yeswantsakthi-hub/NadiSense/docs/NadiSense_VK26-AU-FD-0015_Stage2.pdf

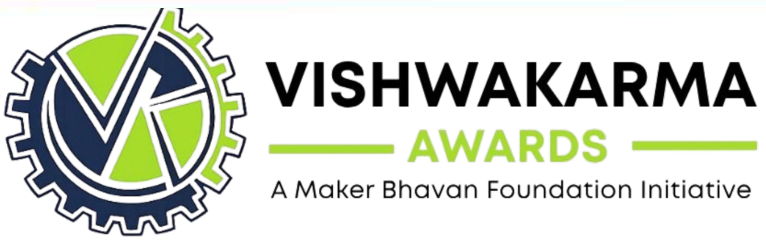
[picture p2: figure]
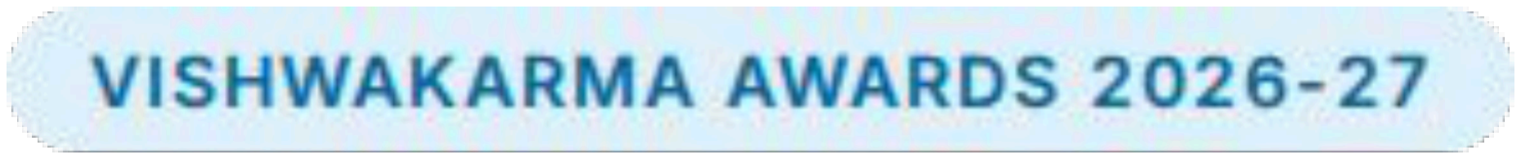
[picture p3: figure]

# Vishwakarma Application ID

# VK26-AU-FD-0015

## NadiSense: a ring that checks your pulse, oxygen and temperature while you sleep

Frontier Diagnostics: The Next Vital Signs, Team Ring of Care, Rajalakshmi Engineering College

Sources: NFHS-5 analyses (medRxiv 2024); ResMed economic model, ISPOR Europe 2025; MoHFW Health Dynamics of India 2022-23.

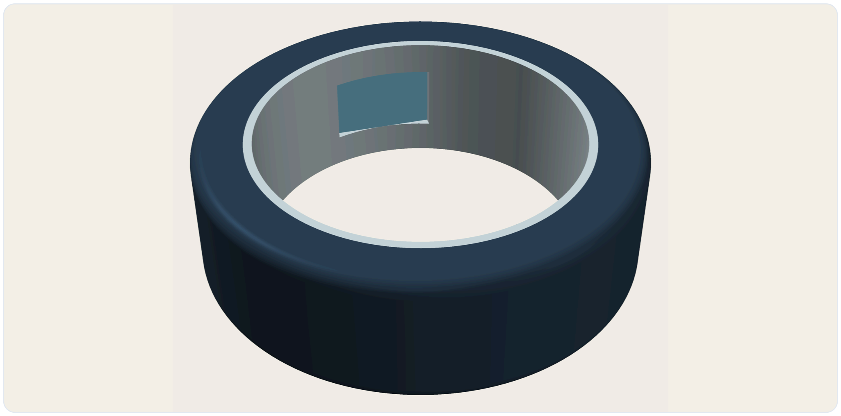
[picture p4: figure]

Figure: NadiSense ring v2, CAD render (AI Generated)

### Target Beneficiary & Problem Statement

Target User: adults aged 30–60 in semi-urban and rural India, starting with Chennai’s peri-urban PHC/CHC areas.
Pain Point: hypertension, irregular heart rhythm and sleep apnea are only caught by one-off tests: a BP cuff, an ECG or an overnight sleep study.
Gap: nobody measures at night, and rural clinics often have no specialist to run these tests.
Existing Solutions: current smart rings are fitness gadgets for city users, with no link to a PHC referral.
Problem Context & Project Overview | VK26-AU-FD-0015
Project: NadiSense | Track: Frontier Diagnostics | Core idea: a pulse, SpO₂ and temperature ring worn overnight.

Sources: NFHS-5 hypertension cascade (medRxiv); ResMed economic model, ISPOR Europe 2025; MoHFW Health Dynamics of India 2022-23.

### Silent signs

Snoring, fatigue, palpitations
dismissed as normal

### No routine check

BP checked rarely; nobody
measures at night

### Facility-bound

Cuff at PHC, ECG/Holter,
overnight sleep lab

### Late detection

First sign is often a stroke or heart event

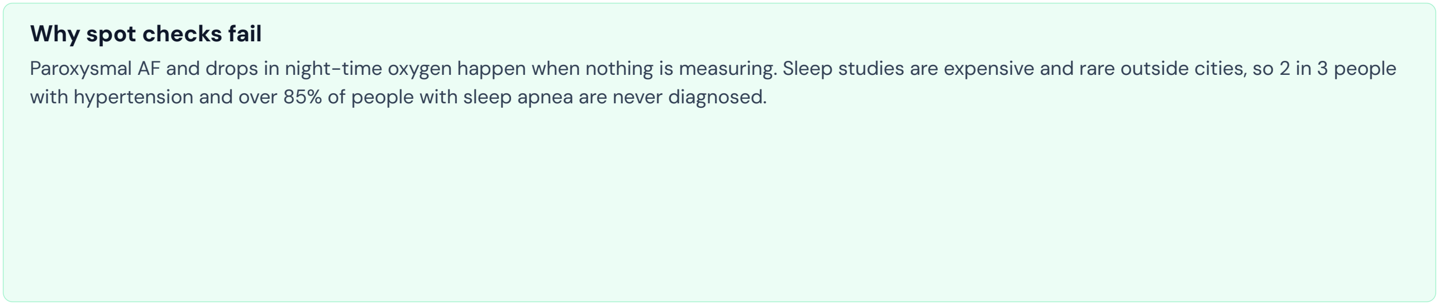
[picture p5: figure]
Why spot checks fail

Paroxysmal AF and drops in night-time oxygen happen when nothing is measuring. Sleep studies are expensive and rare outside cities, so 2 in 3 people with hypertension and over 85% of people with sleep apnea are never diagnosed.

User Journey: Before State | VK26-AU-FD-0015

Bottleneck: every step depends on the patient going to a clinic, so problems are found late.

~8 h

DATA PER NIGHT

0

CLINIC VISITS TO SCREEN

< 60 s

SYNC TO RISK REPORT

≈ ₹100

HARDWARE PER SCREENING

### Wear the ring

No cuff, no clinic, no straps

### Passive capture

Pulse wave, HRV, SpO₂, skin temp

### Risk flags

Stiffness, AF-type rhythm, apnea

### Early referral

Report for PHC doctor or
teleconsult

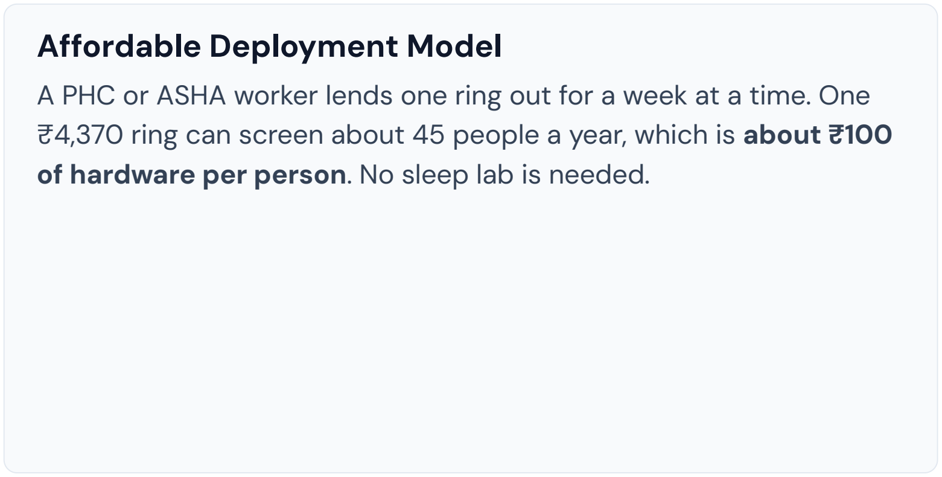
[picture p6: figure]
Affordable Deployment Model

A PHC or ASHA worker lends one ring out for a week at a time. One ₹4,370 ring can screen about 45 people a year, which is about ₹100 of hardware per person. No sleep lab is needed.

User Journey: After State | VK26-AU-FD-0015

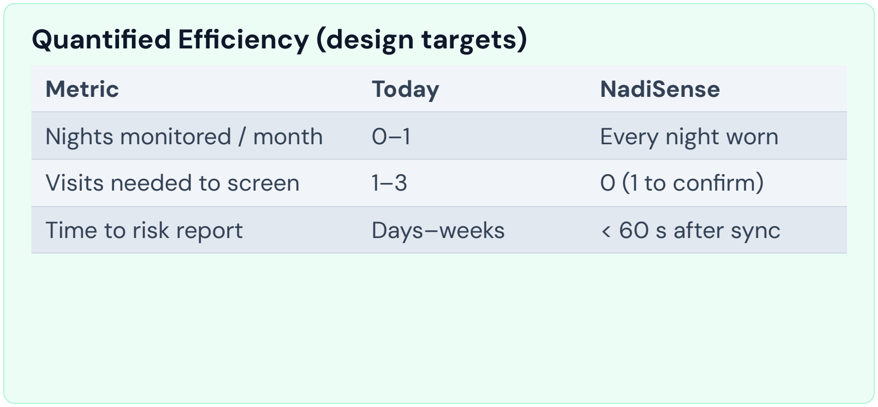
[picture p7: figure]
Quantified Efficiency (design targets); Metric; Today; NadiSense; Nights monitored / month; Every night worn; Visits needed to screen; 0 (1 to confirm); Time to risk report; Days–weeks; < 60 s after sync

Scope: NadiSense flags risk and refers to a doctor; it does not diagnose. We will test these targets in Stage 3.

### Sensing

### Control & Power

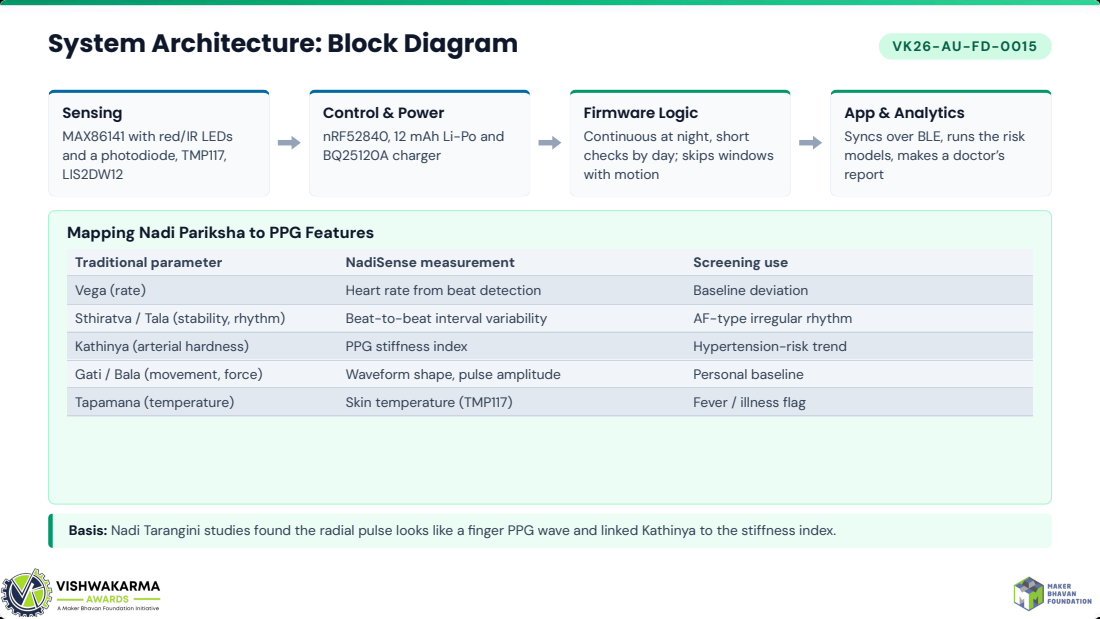
[picture p8: page 5]
System Architecture: Block Diagram

Firmware Logic
Continuous at night, short
checks by day; skips windows
with motion

App & Analytics
Syncs over BLE, runs the risk
models, makes a doctor’s
report

MAX86141 with red/IR LEDs
and a photodiode, TMP117,
LIS2DW12

nRF52840, 12 mAh Li-Po and
BQ25120A charger

Mapping Nadi Pariksha to PPG Features

Traditional parameter | NadiSense measurement | Screening use
Vega (rate) | Heart rate from beat detection | Baseline deviation
Sthiratva / Tala (stability, rhythm) | Beat-to-beat interval variability | AF-type irregular rhythm
Kathinya (arterial hardness) | PPG stiffness index | Hypertension-risk trend
Gati / Bala (movement, force) | Waveform shape, pulse amplitude | Personal baseline
Tapamana (temperature) | Skin temperature (TMP117) | Fever / illness flag

Basis: Nadi Tarangini studies found the radial pulse looks like a finger PPG wave and linked Kathinya to the stiffness index.

≈ 3 g

# 40 µA

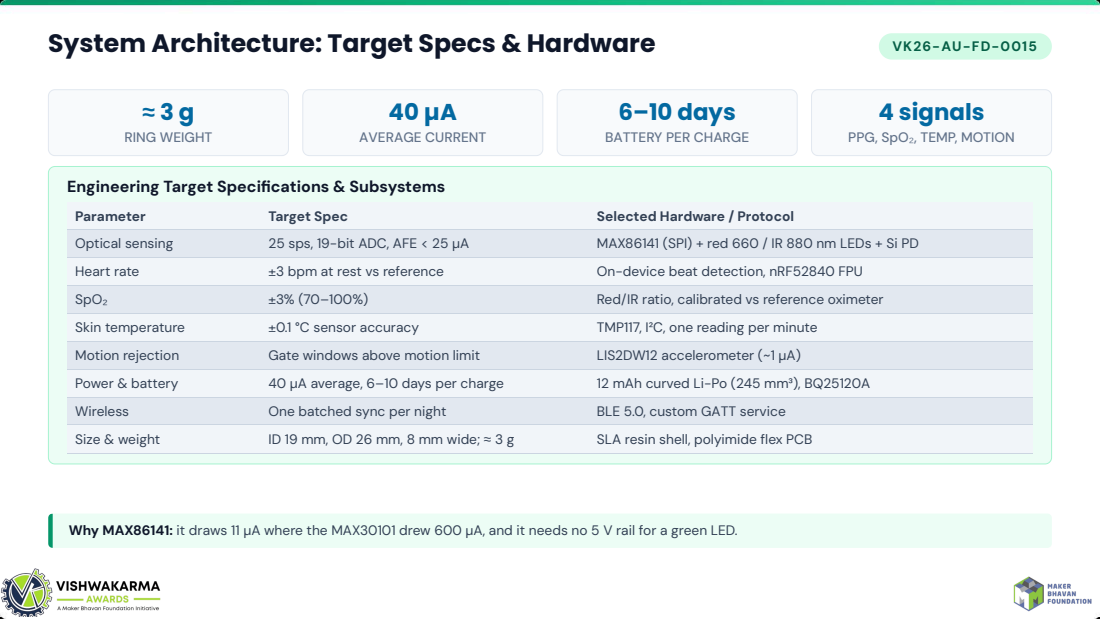
[picture p9: page 6]
RING WEIGHT; AVERAGE CURRENT; 6–10 days; 4 signals; System Architecture: Target Specs & Hardware

BATTERY PER CHARGE

PPG, SpO₂, TEMP, MOTION

Engineering Target Specifications & Subsystems

Parameter | Target Spec | Selected Hardware / Protocol
Optical sensing | 25 sps, 19-bit ADC, AFE < 25 µA | MAX86141 (SPI) + red 660 / IR 880 nm LEDs + Si PD
Heart rate | ±3 bpm at rest vs reference | On-device beat detection, nRF52840 FPU
SpO₂ | ±3% (70–100%) | Red/IR ratio, calibrated vs reference oximeter
Skin temperature | ±0.1 °C sensor accuracy | TMP117, I²C, one reading per minute
Motion rejection | Gate windows above motion limit | LIS2DW12 accelerometer (~1 µA)
Power & battery | 40 µA average, 6–10 days per charge | 12 mAh curved Li-Po (245 mm³), BQ25120A
Wireless | One batched sync per night | BLE 5.0, custom GATT service
Size & weight | ID 19 mm, OD 26 mm, 8 mm wide; ≈ 3 g | SLA resin shell, polyimide flex PCB

Why MAX86141: it draws 11 µA where the MAX30101 drew 600 µA, and it needs no 5 V rail for a green LED.

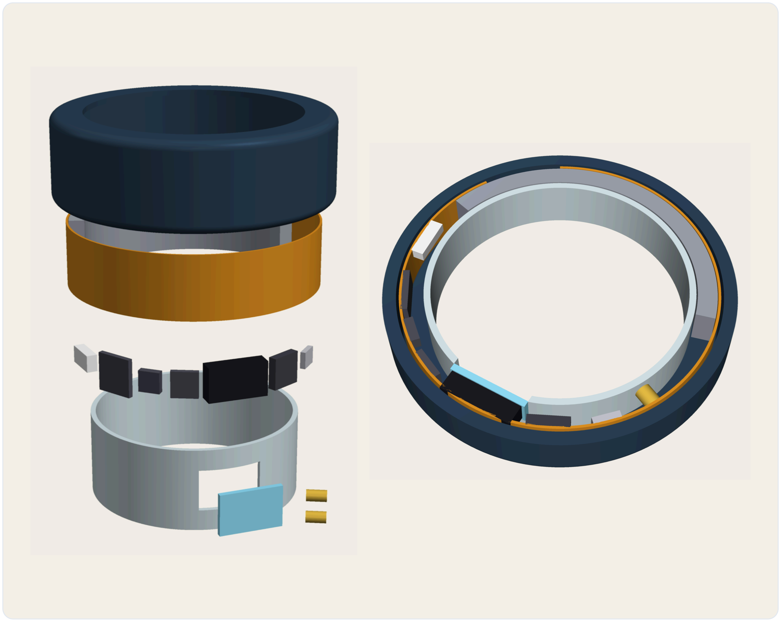
[picture p10: figure]

Figure: exploded assembly and half-section, ring v2 (AI Generated)

### Mechanical Design & Material Selection

Envelope: ID 19 mm, OD 26 mm, 8 mm wide; wall = 0.5 liner + 2.0 cavity + 1.0 shell.
Shell: biocompatible SLA resin U-channel, 0.8 mm outer and 0.3 mm inner fillets.
Liner: clear resin with a 6 × 4 mm optical window sealed in clear epoxy.
Layout: 245 mm³ curved Li-Po on the back of the finger; optics on the palm side; flex PCB wraps 330°.
Mass: ≈ 3 g estimated from CAD volumes.
CAD Design & Mechanical Specs | VK26-AU-FD-0015

Design Iteration: we first planned a 20–40 mAh cell, but the CAD cavity holds only 245 mm³, so we resized it to 12 mAh.

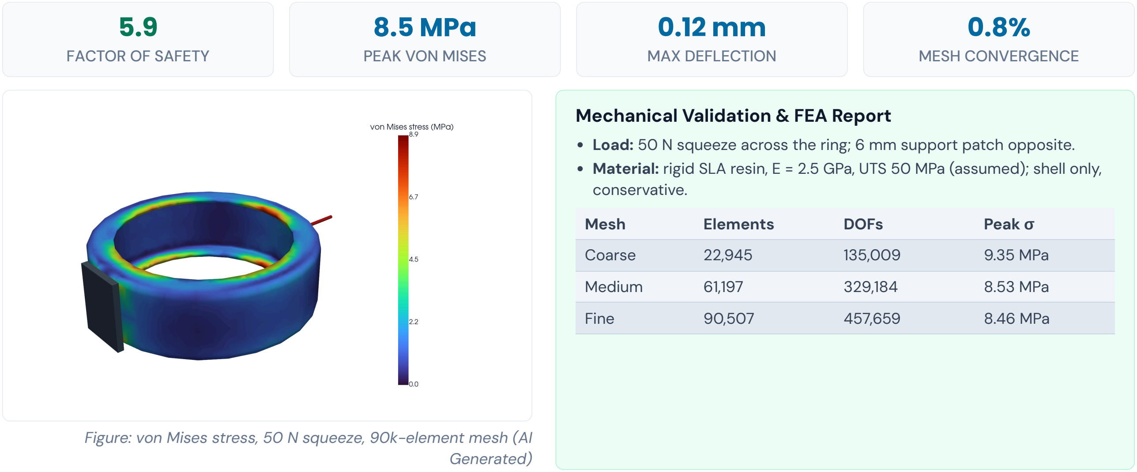
[picture p11: figure]
FACTOR OF SAFETY; 8.5 MPa; PEAK VON MISES; MAX DEFLECTION; MESH CONVERGENCE; Generated); Mechanical Validation & FEA Report; conservative.; Mesh; Elements; DOFs; Peak σ; Coarse; 9.35 MPa; Medium; 8.53 MPa; Fine; 8.46 MPa

Figure: von Mises stress, 50 N squeeze, 90k-element mesh (AI

Load: 50 N squeeze across the ring; 6 mm support patch opposite. Material: rigid SLA resin, E = 2.5 GPa, UTS 50 MPa (assumed); shell only,

CAD Design: FEA Stress Analysis | VK26-AU-FD-0015

Design Iteration: we added 0.3 mm fillets at the inner channel corners before the analysis to remove sharp stress points.

Electronics Schematics & Power Budget | VK26-AU-FD-0015

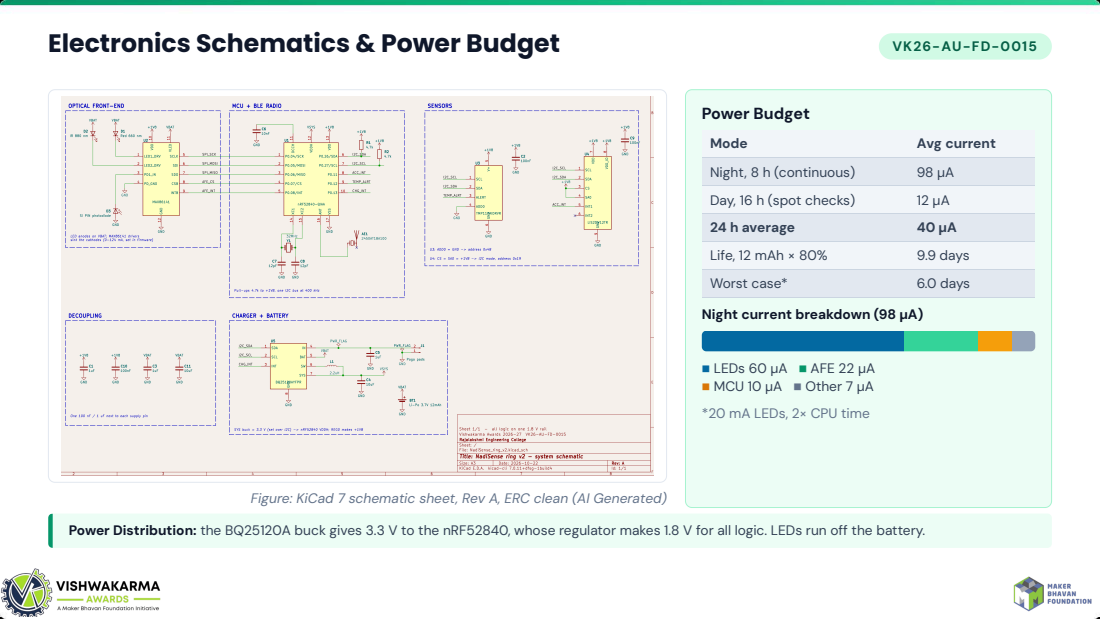
[picture p12: page 9]
Power Budget

Mode | Avg current
Night, 8 h (continuous) | 98 µA
Day, 16 h (spot checks) | 12 µA
24 h average | 40 µA
Life, 12 mAh × 80% | 9.9 days
Worst case* | 6.0 days

Night current breakdown (98 µA)

■ LEDs 60 µA ■ AFE 22 µA
■ MCU 10 µA ■ Other 7 µA
*20 mA LEDs, 2× CPU time

Figure: KiCad 7 schematic sheet, Rev A, ERC clean (AI Generated)

Power Distribution: the BQ25120A buck gives 3.3 V to the nRF52840, whose regulator makes 1.8 V for all logic. LEDs run off the battery.

### Itemized Bill of Materials (one ring)

Ref | Component | Part / Specification | Sourcing / Lead Time | Est. (INR)
U1 | BLE SoC | nRF52840, WLCSP | Distributor (5–7 days) | ₹420
U2 | Optical AFE | MAX86141, WLP | Distributor (5–7 days) | ₹520
U3 | Temperature | TMP117, ±0.1 °C | Distributor (5–7 days) | ₹260
U4 | Accelerometer | LIS2DW12 | Distributor (5–7 days) | ₹140
U5 | Charger | BQ25120A | Distributor (5–7 days) | ₹180
D1–D3 | Optics | Red/IR SMD LEDs, Si photodiode | Distributor (5–7 days) | ₹220
Y1, AE1, L1 | RF + passives | 32 MHz crystal, chip antenna, 2.2 µH, R/C | Distributor (5–7 days) | ₹230
PCB | Flex PCB | 2-layer polyimide, 0.2 mm | Imported (10–14 days) | ₹700
BT1 | Battery | 12 mAh curved Li-Po (custom) | Imported (3–4 weeks) | ₹1,200
MECH | Shell, liner, potting | SLA resin, epoxy, silicone, pogo pads | Local (4 days) | ₹500
| Total per unit | | | ₹4,370
Electronics BOM & Procurement | VK26-AU-FD-0015

Procurement Risk: the custom curved cell has the longest lead time, so it is ordered first, in Month 1.

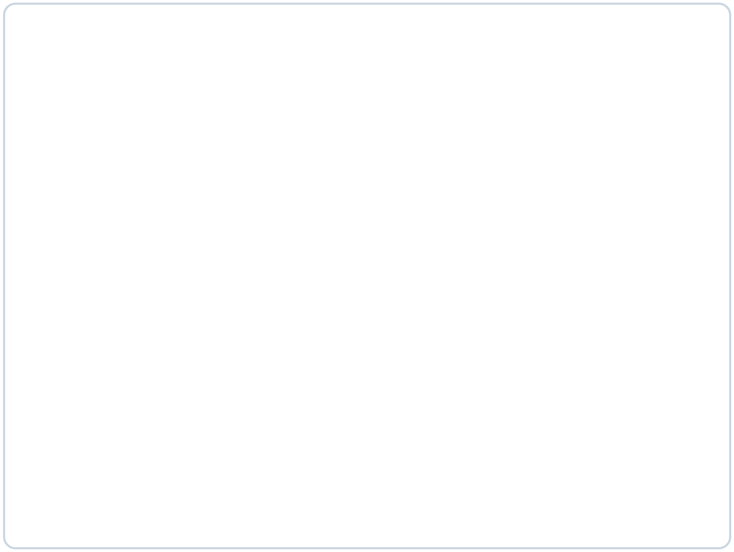
[picture p13: figure]

Figure: Team Ring of Care, REC

### Stage 1 to Stage 2 Design Iterations

Form factor: moved from a handheld reader to a ring so we can record through the night.
Sensing: added SpO₂, skin temperature and motion sensing to the PPG.
Optical AFE: the power budget ruled out the MAX30101 (600 µA), so we moved to the MAX86141 (11 µA).
Battery: cut from 20–40 mAh to 12 mAh to fit the CAD cavity; still 6–10 days per charge.
Shell: 0.3 mm internal fillets added; FEA safety factor 5.9 at 50 N.
Software: companion app live at nadisense-app.vercel.app in 8 Indian languages, running on simulated sensor data until the ring is built.
Repository: github.com/yeswantsakthi-hub/NadiSense, with STEP files, KiCad project, FEA scripts, power budget and app code.
Your Maker Journey | VK26-AU-FD-0015

Institutional Sign-Off: design reviewed by Faculty Guide Dr. L. Bhagyalakshmi, Professor, Dept. of ECE (WSN, IoT, ML & AI), Rajalakshmi Engineering

Your Maker Journey: Design Tools | VK26-AU-FD-0015

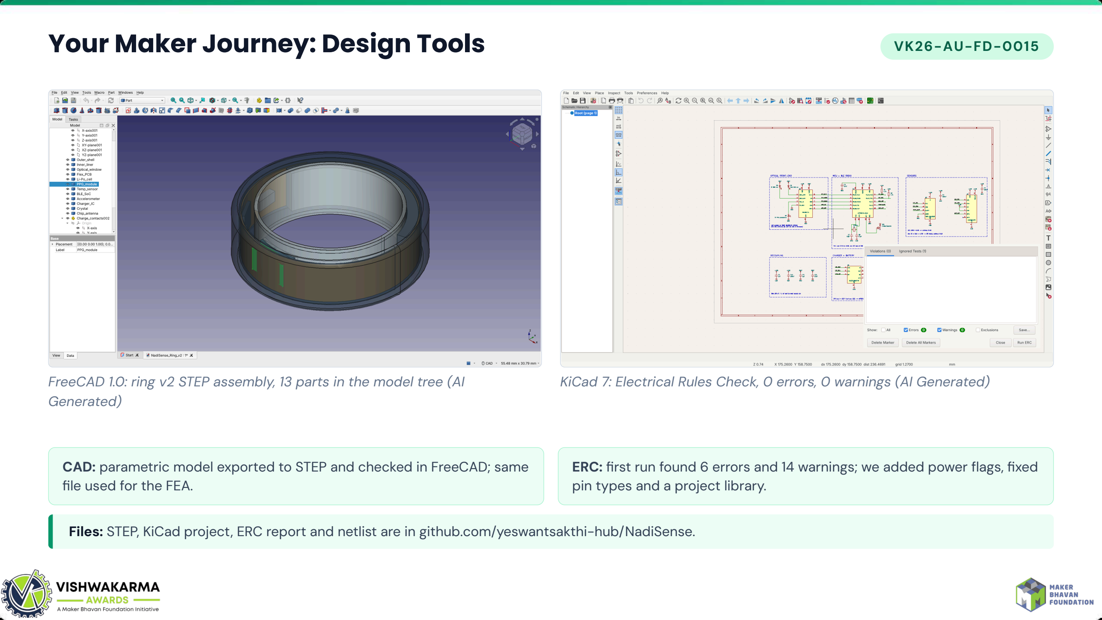
[picture p14: page 12]

FreeCAD 1.0: ring v2 STEP assembly, 13 parts in the model tree (AI Generated)

KiCad 7: Electrical Rules Check, 0 errors, 0 warnings (AI Generated)

CAD: parametric model exported to STEP and checked in FreeCAD; same file used for the FEA.

ERC: first run found 6 errors and 14 warnings; we added power flags, fixed pin types and a project library.

Files: STEP, KiCad project, ERC report and netlist are in github.com/yeswantsakthi-hub/NadiSense.

### Design FMEA (Severity × Occurrence × Detection, each 1–10)

Failure Mode | Potential Hazard | Embedded Fail-Safe / Mitigation | S | O | D | RPN
Cell overheat | Burn at the finger | Charger thermal limit; cut-off above 43 °C | 9 | 2 | 3 | 54
LED skin heating | Warmth, discomfort | LED current cap; duty-cycled sampling | 5 | 2 | 4 | 40
Motion artifact | False alert | IMU gating; alert only on repeat episodes | 4 | 6 | 4 | 96
Missed event | False reassurance | Never shows “all clear”; clinical check | 8 | 4 | 6 | 192
Data exposure | Privacy breach | On-phone processing; encrypted BLE and storage | 6 | 2 | 5 | 60

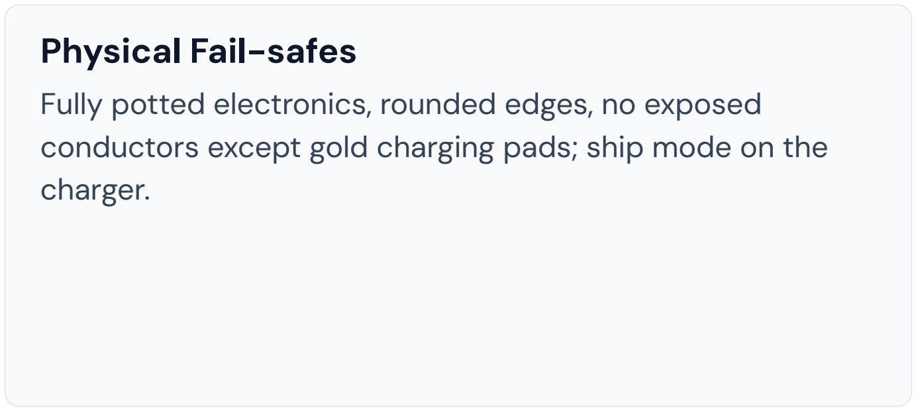
[picture p15: figure]
Physical Fail-safes; charger.

Fully potted electronics, rounded edges, no exposed conductors except gold charging pads; ship mode on the

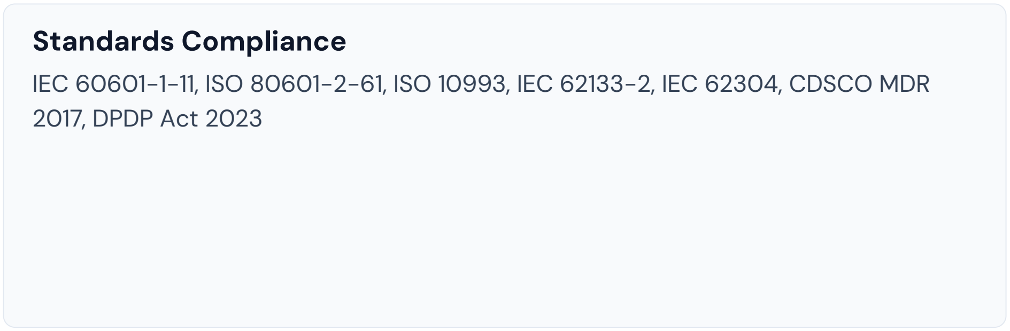
[picture p16: figure]
Standards Compliance; 2017, DPDP Act 2023

IEC 60601-1-11, ISO 80601-2-61, ISO 10993, IEC 62133-2, IEC 62304, CDSCO MDR

Safety & Hazard Mitigation | VK26-AU-FD-0015

Highest RPN: missed event (192). The app never says “all clear”, and every flag ends in a referral.

Nov 2026 | Dec 2026 | Jan 2027 | Feb 2027
Roadmap: 4-Month Fabrication Plan | VK26-AU-FD-0015

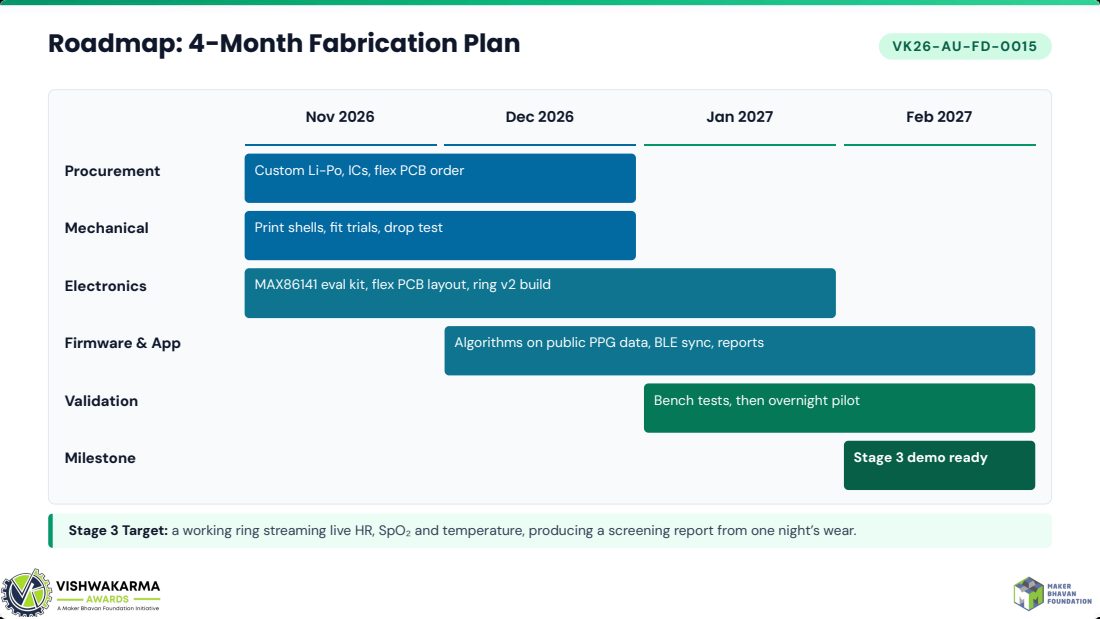
[picture p17: page 14]
Procurement; Custom Li-Po, ICs, flex PCB order; Mechanical; Print shells, fit trials, drop test; Electronics; MAX86141 eval kit, flex PCB layout, ring v2 build; Firmware & App; Algorithms on public PPG data, BLE sync, reports; Validation; Bench tests, then overnight pilot; Milestone; Stage 3 demo ready

Stage 3 Target: a working ring streaming live HR, SpO₂ and temperature, producing a screening report from one night’s wear.

Technical Challenges & Risks | VK26-AU-FD-0015

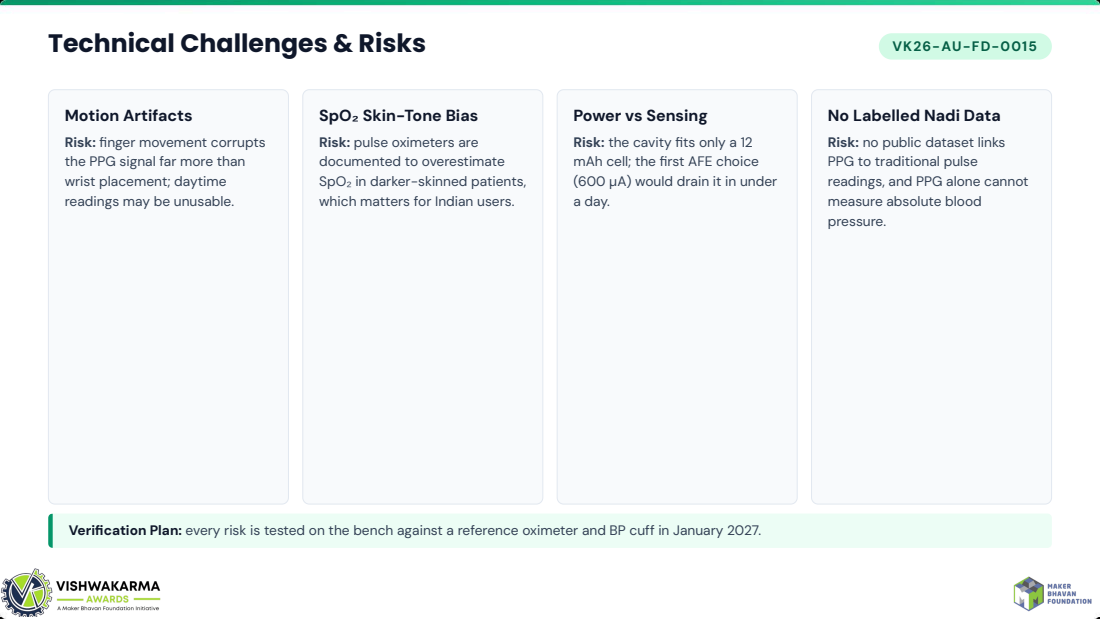
[picture p18: page 15]

Motion Artifacts
Risk: finger movement corrupts
the PPG signal far more than
wrist placement; daytime
readings may be unusable.

SpO₂ Skin-Tone Bias
Risk: pulse oximeters are
documented to overestimate
SpO₂ in darker-skinned patients,
which matters for Indian users.

Power vs Sensing
Risk: the cavity fits only a 12
mAh cell; the first AFE choice
(600 µA) would drain it in under
a day.

No Labelled Nadi Data
Risk: no public dataset links
PPG to traditional pulse
readings, and PPG alone cannot
measure absolute blood
pressure.

Verification Plan: every risk is tested on the bench against a reference oximeter and BP cuff in January 2027.

Potential Solutions & Risk Mitigation | VK26-AU-FD-0015

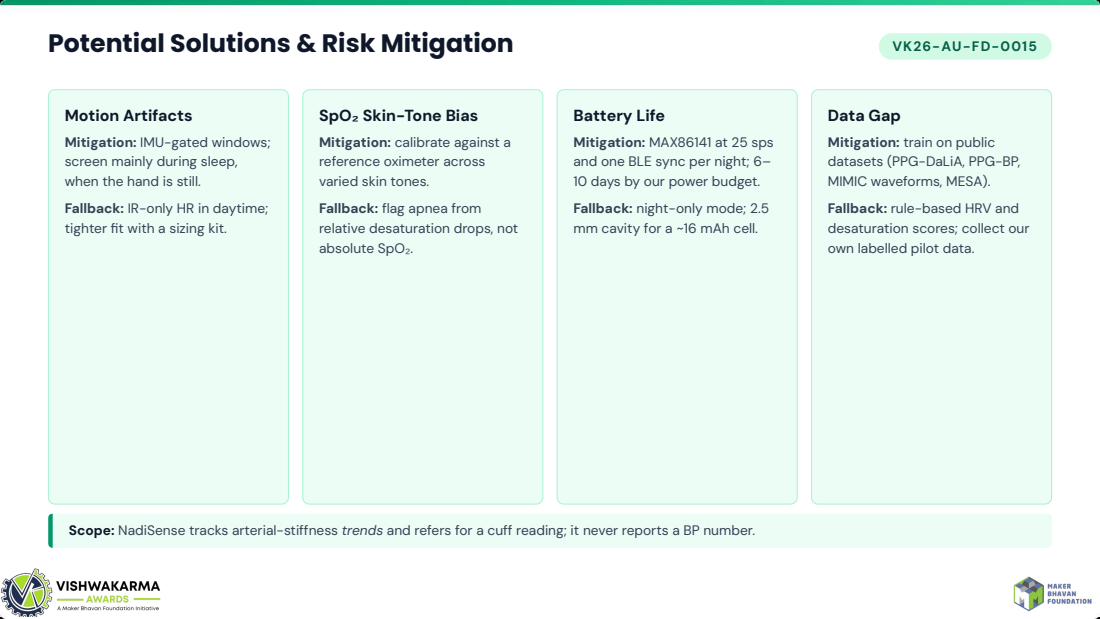
[picture p19: page 16]

Motion Artifacts
Mitigation: IMU-gated windows;
screen mainly during sleep,
when the hand is still.
Fallback: IR-only HR in daytime;
tighter fit with a sizing kit.

SpO₂ Skin-Tone Bias
Mitigation: calibrate against a
reference oximeter across
varied skin tones.
Fallback: flag apnea from
relative desaturation drops, not
absolute SpO₂.

Battery Life
Mitigation: MAX86141 at 25 sps
and one BLE sync per night; 6–
10 days by our power budget.
Fallback: night-only mode; 2.5
mm cavity for a ~16 mAh cell.

Data Gap
Mitigation: train on public
datasets (PPG-DaLiA, PPG-BP,
MIMIC waveforms, MESA).
Fallback: rule-based HRV and
desaturation scores; collect our
own labelled pilot data.

Scope: NadiSense tracks arterial-stiffness trends and refers for a cuff reading; it never reports a BP number.
