yeswantsakthi-hub/NadiSense/docs/screenshots/freecad_ring.png

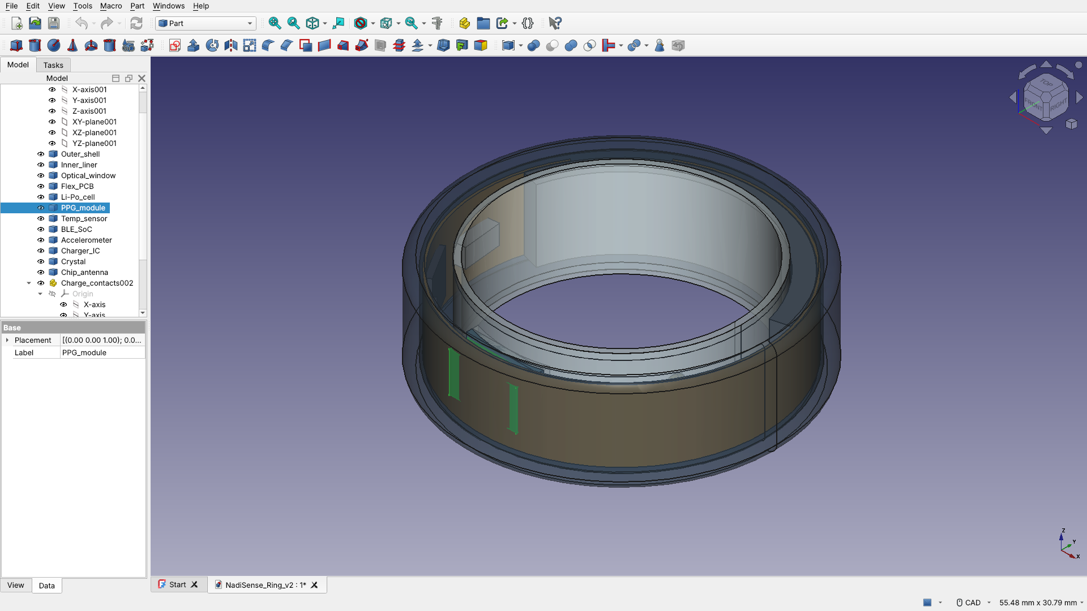
docs/screenshots/freecad_ring.png
