yeswantsakthi-hub/NadiSense/docs/screenshots/kicad_erc.png

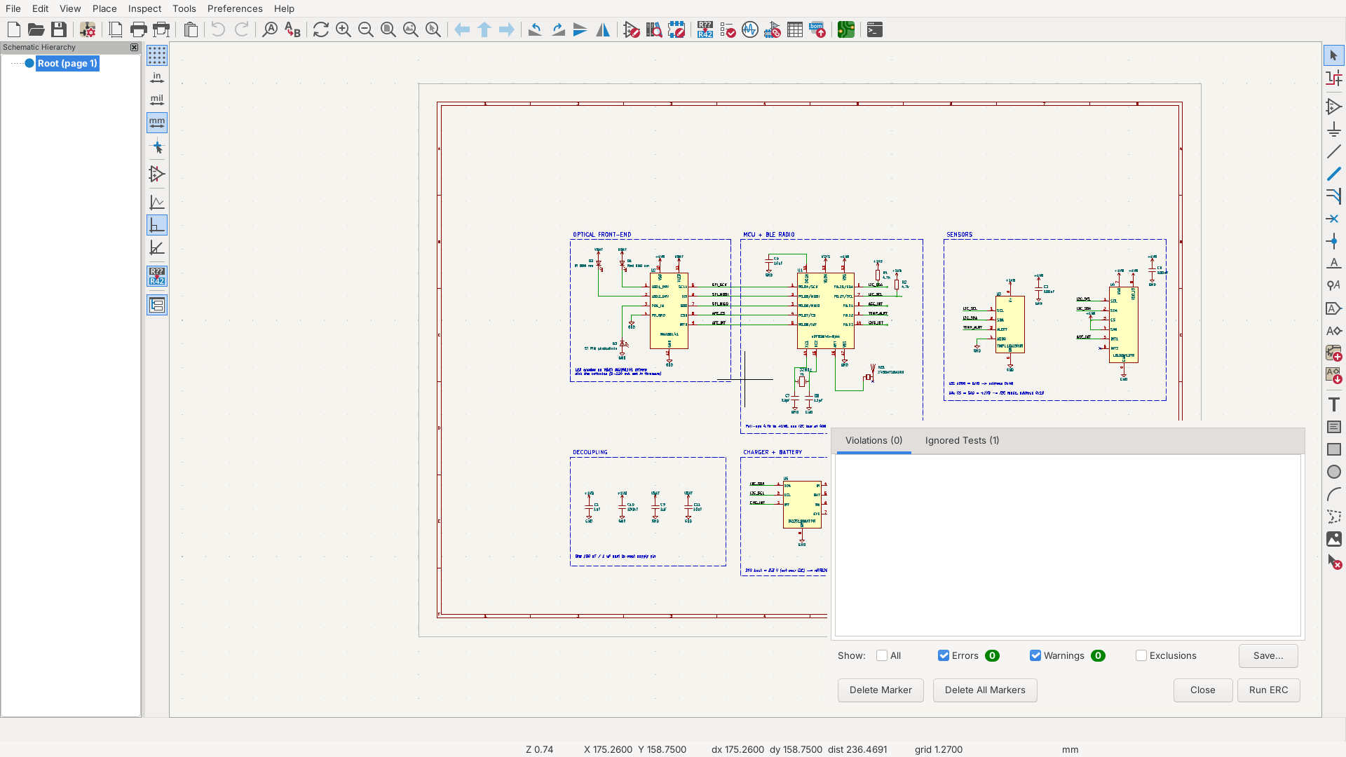
docs/screenshots/kicad_erc.png
