yeswantsakthi-hub/NadiSense/electronics/kicad/NadiSense_ring_v2.png

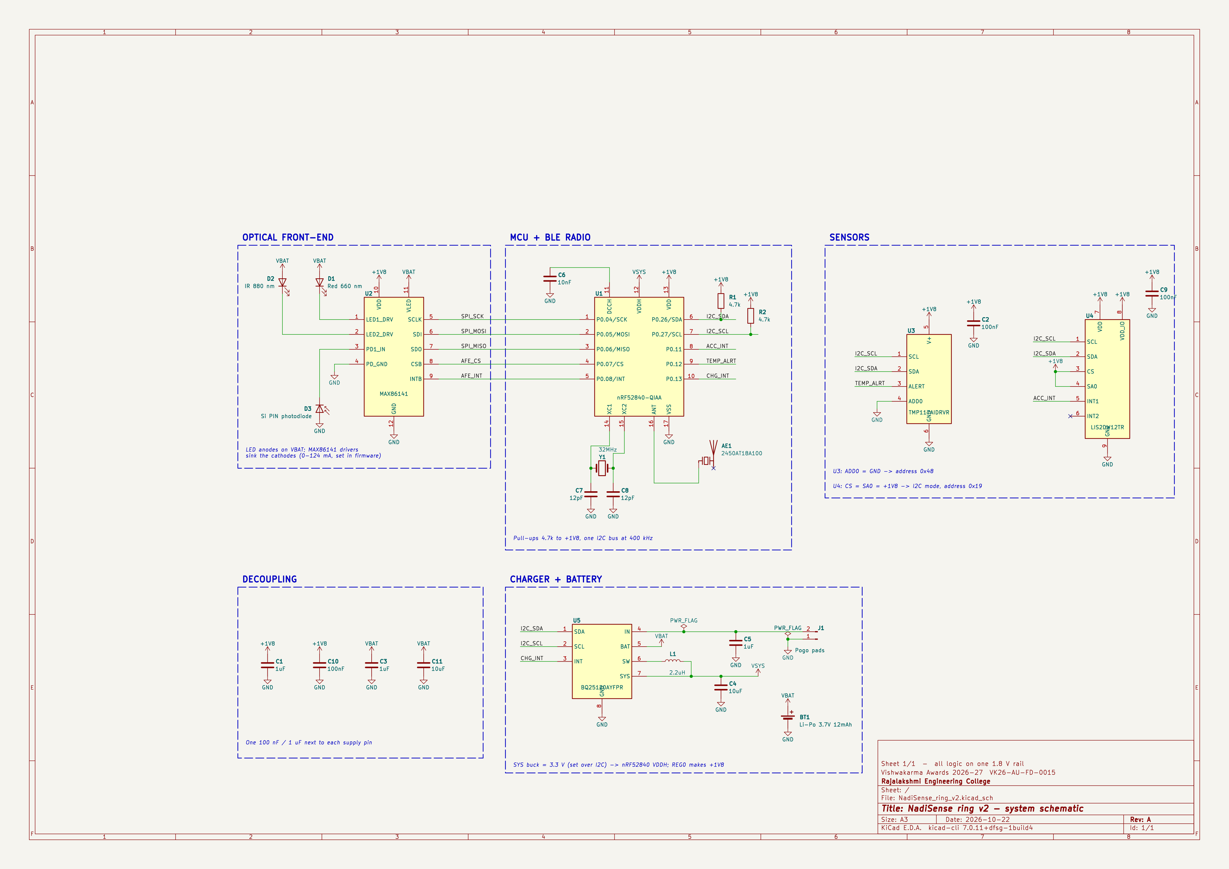
electronics/kicad/NadiSense_ring_v2.png
