yeswantsakthi-hub/NadiSense/electronics/ring_v2_revB/images/pcb3d_flat.png

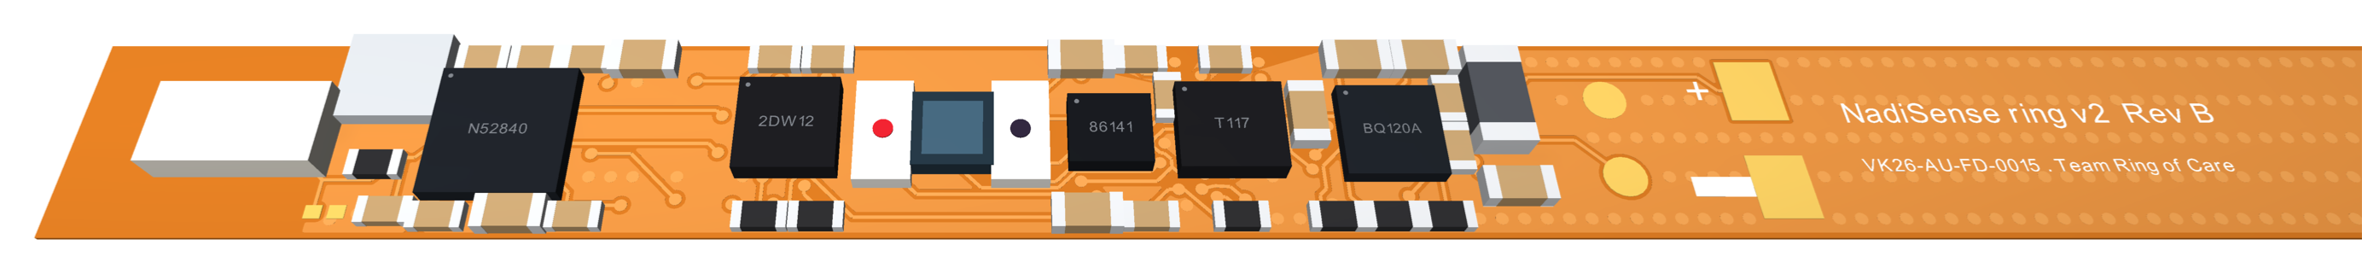
electronics/ring_v2_revB/images/pcb3d_flat.png
