yeswantsakthi-hub/NadiSense/electronics/ring_v2_revB/images/pcb3d_ring.png

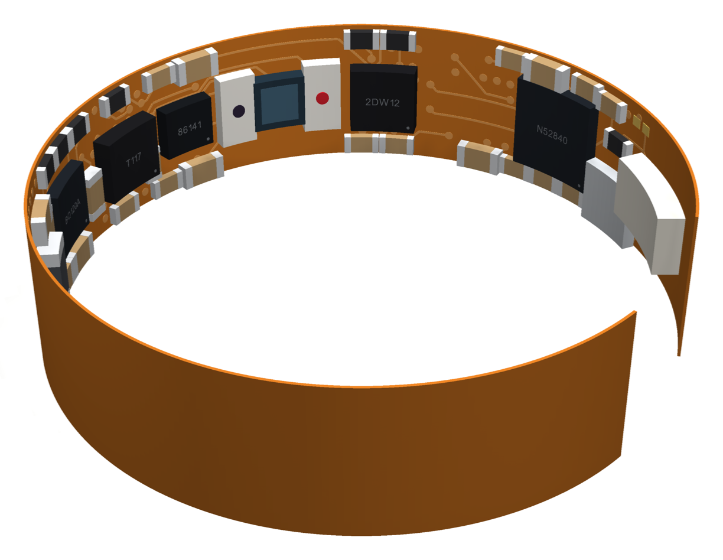
electronics/ring_v2_revB/images/pcb3d_ring.png
