yeswantsakthi-hub/NadiSense/electronics/ring_v2_revB/images/pcb_bottom.png

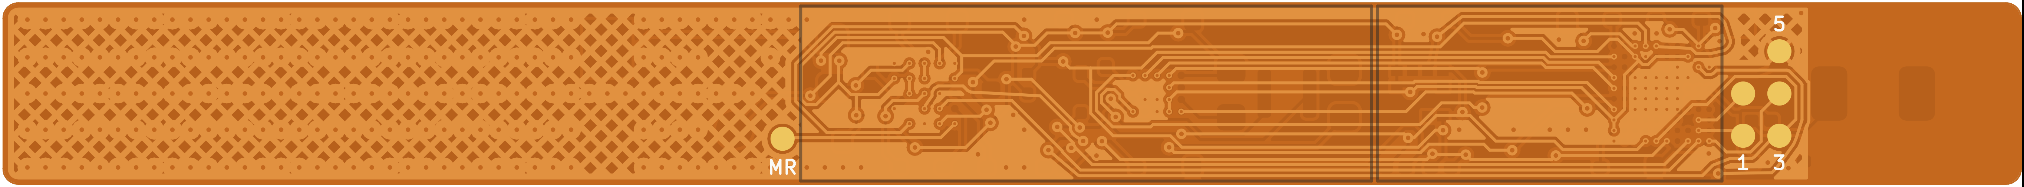
electronics/ring_v2_revB/images/pcb_bottom.png
