yeswantsakthi-hub/NadiSense/electronics/ring_v2_revB/images/pcb_layers.png

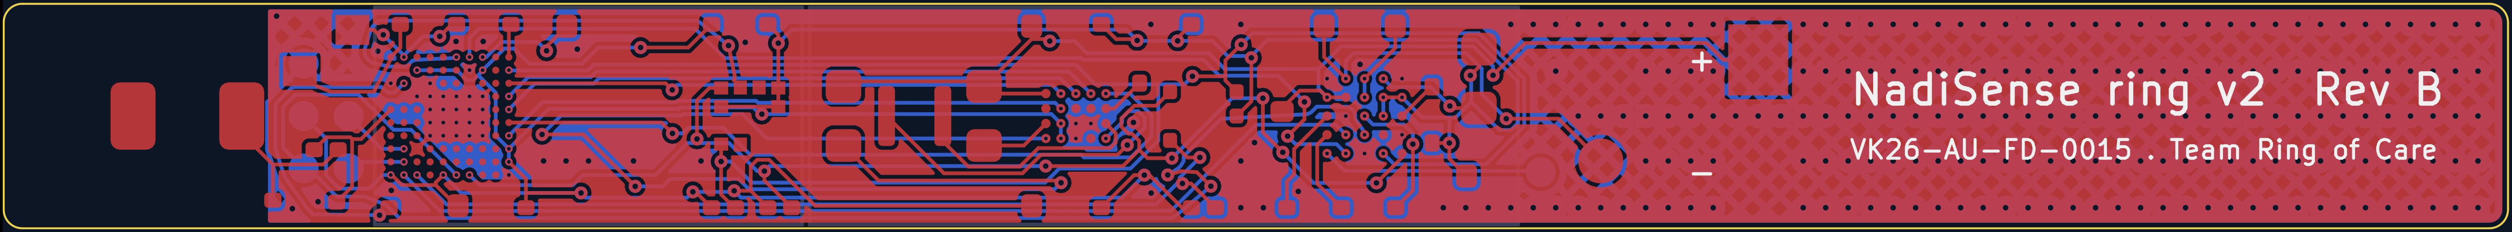
electronics/ring_v2_revB/images/pcb_layers.png
