yeswantsakthi-hub/NadiSense/electronics/ring_v2_revB/images/pcb_routing.png

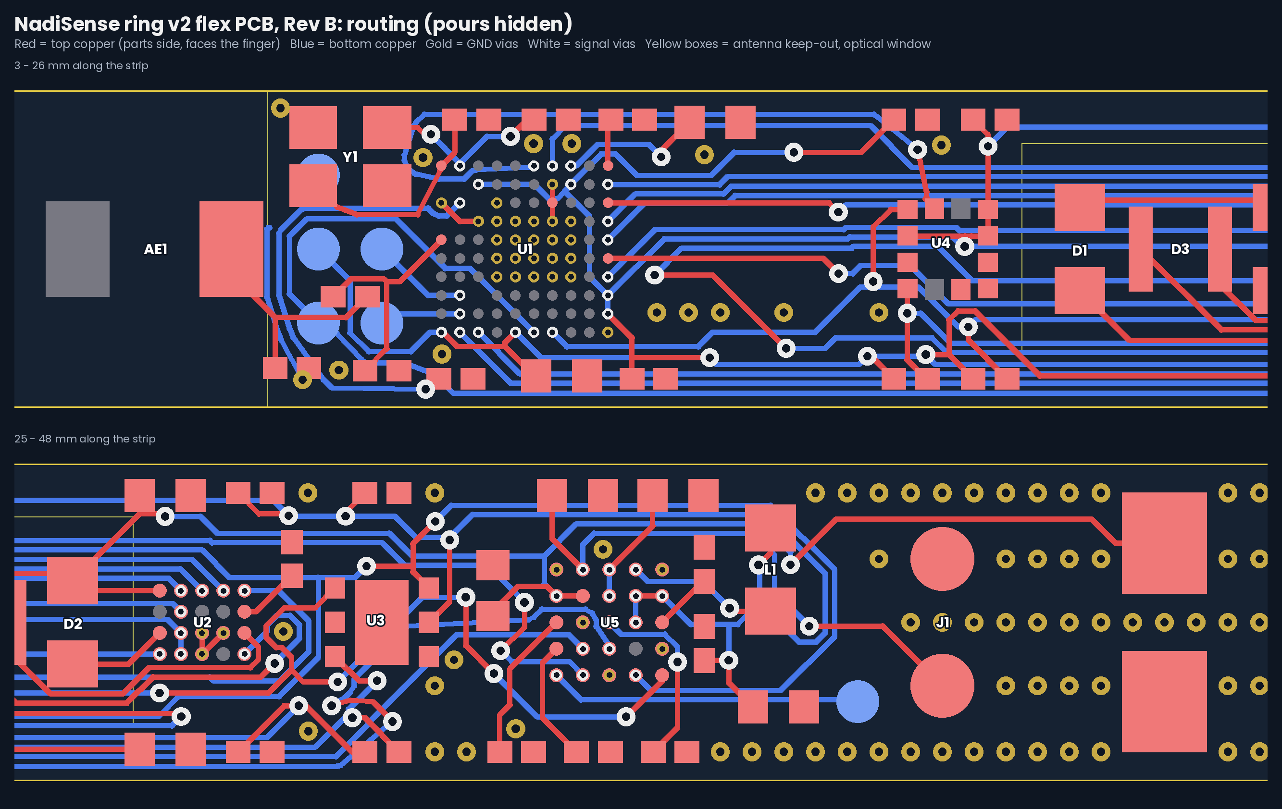
electronics/ring_v2_revB/images/pcb_routing.png
