yeswantsakthi-hub/NadiSense/fea/fea_stress.png

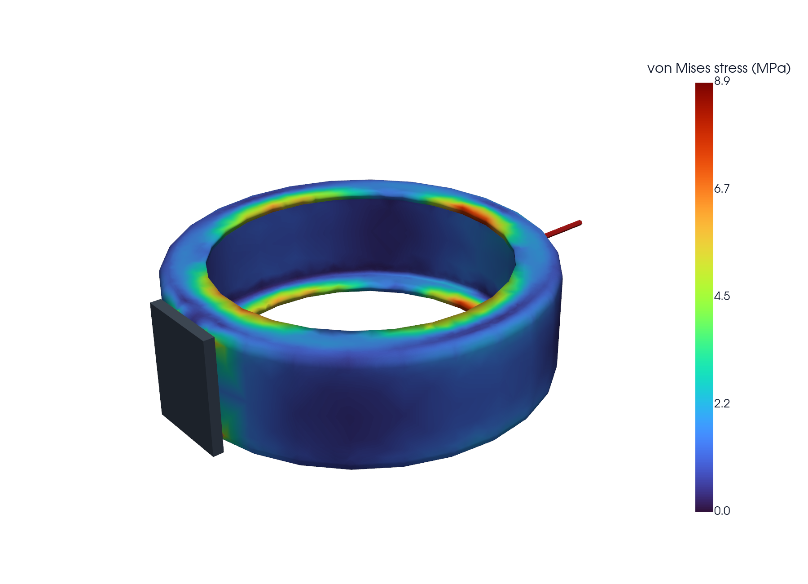
fea/fea_stress.png
