yeswantsakthi-hub/NadiSense/renders/flex_pcb.png

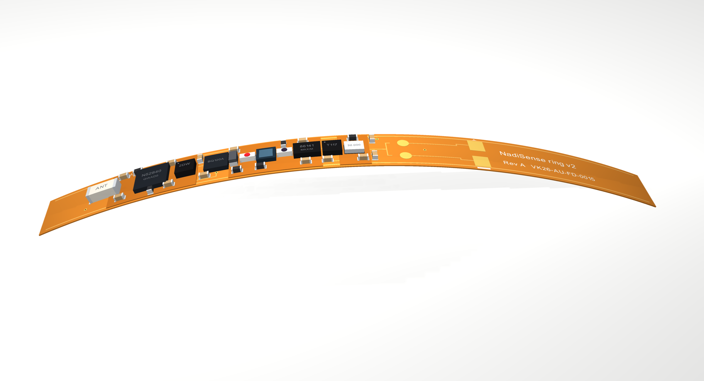
renders/flex_pcb.png
