yeswantsakthi-hub/NadiSense/renders/flex_pcb_labelled.png

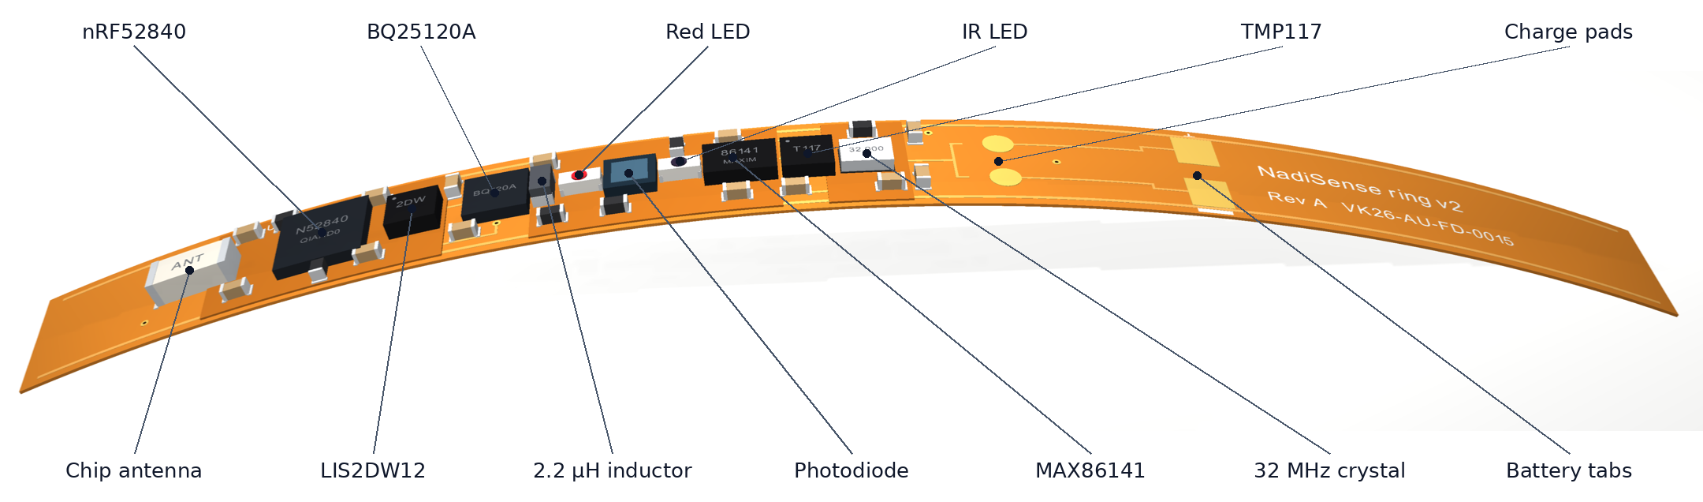
renders/flex_pcb_labelled.png
