yeswantsakthi-hub/NadiSense/renders/flex_pcb_plain.png

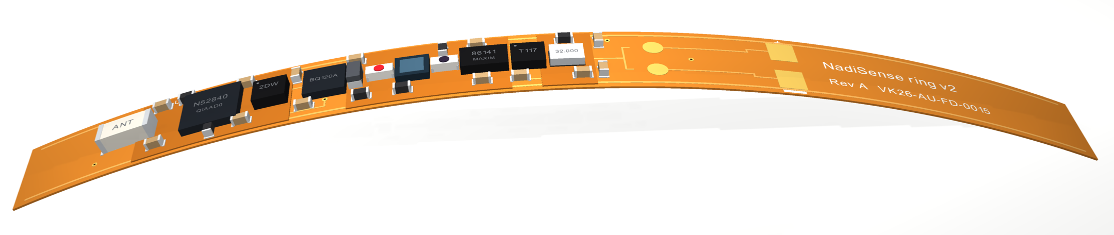
renders/flex_pcb_plain.png
