yeswantsakthi-hub/NadiSense/renders/flex_ring.png

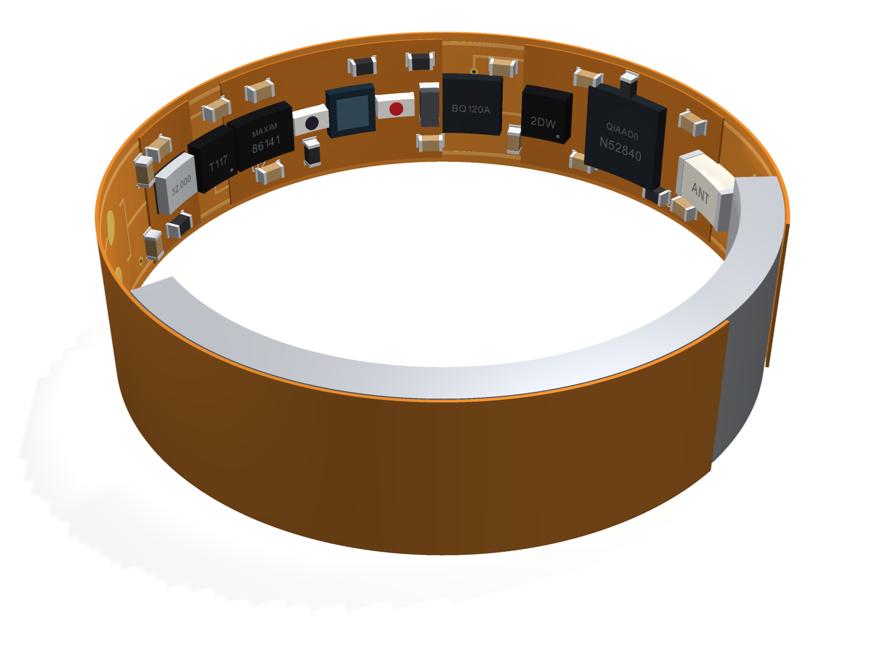
renders/flex_ring.png
