yeswantsakthi-hub/NadiSense/renders/iso_exploded_crop.png

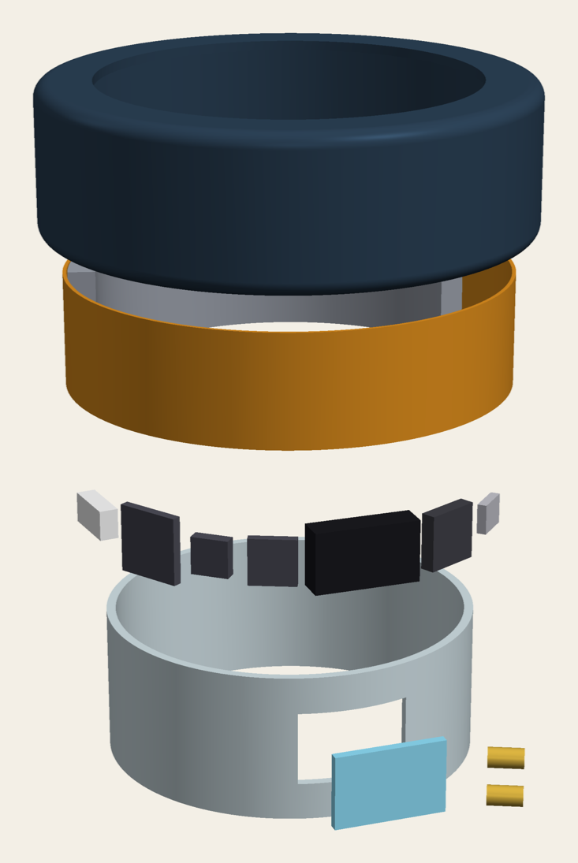
renders/iso_exploded_crop.png
