yeswantsakthi-hub/NadiSense/renders/iso_section_crop.png

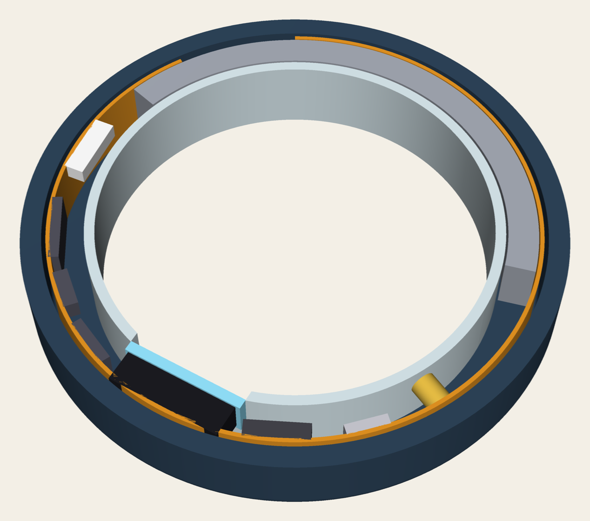
renders/iso_section_crop.png
