yeswantsakthi-hub/NadiSense/electronics/ring_v2_revB/fab/NadiSense_ring_v2_revB-BOM.csv

Qty | References | Value | Footprint | Side | Note
1 | AE1 | 2450AT18A100 | RF_Antenna:Johanson_2450AT18x100 | Top
1 | BT1 | Li-Po 3.7V 12mAh | NadiSense:LiPo_Tabs_1.6x1.9mm | Top
7 | C1 C5 C10 C12 C15 C16 C17 | 100nF | Capacitor_SMD:C_0201_0603Metric | Top
3 | C2 C18 C21 | 1.0uF | Capacitor_SMD:C_0402_1005Metric | Top
1 | C3 | 47nF | Capacitor_SMD:C_0201_0603Metric | Top
2 | C4 C19 | 4.7uF | Capacitor_SMD:C_0402_1005Metric | Top
2 | C6 C7 | 12pF | Capacitor_SMD:C_0201_0603Metric | Top
1 | C8 | 0.8pF | Capacitor_SMD:C_0201_0603Metric | Top | C8: RF pi-match start value - tune with a VNA in the finished ring
0 | C9 | DNP | Capacitor_SMD:C_0201_0603Metric | Top
3 | C11 C14 C20 | 10uF | Capacitor_SMD:C_0402_1005Metric | Top
3 | C13 C22 C23 | 1.0uF | Capacitor_SMD:C_0201_0603Metric | Top
1 | D1 | Red 660nm | LED_SMD:LED_0603_1608Metric | Top
1 | D2 | IR 880nm | LED_SMD:LED_0603_1608Metric | Top
1 | D3 | Si PIN PD 2x2mm | NadiSense:PD_2x2mm | Top
1 | J1 | Charge pads | NadiSense:ChargePads_2xD1.2mm | Top
1 | L1 | 2.2uH | Inductor_SMD:L_0603_1608Metric | Top
1 | L2 | 3.9nH | Inductor_SMD:L_0201_0603Metric | Top | L2: RF pi-match start value - tune with a VNA in the finished ring
2 | R1 R2 | 4.7k | Resistor_SMD:R_0201_0603Metric | Top
2 | R3 R6 | 10k | Resistor_SMD:R_0201_0603Metric | Top | R6: TS: 10k emulates a 10k NTC at 25 C (cell has no NTC); TS can be disabled over I2C
1 | R4 | R_ISET | Resistor_SMD:R_0201_0603Metric | Top | R4: fast-charge current set resistor; value per TI BQ25120A data sheet (ISET), charge current is also set over I2C
1 | R5 | R_IPRETERM | Resistor_SMD:R_0201_0603Metric | Top | R5: pre-charge/termination resistor; value per TI data sheet (IPRETERM)
1 | TP1 | SWDIO | NadiSense:TestPad_D0.8mm | Bottom
1 | TP2 | SWDCLK | NadiSense:TestPad_D0.8mm | Bottom
1 | TP3 | nRESET | NadiSense:TestPad_D0.8mm | Bottom
1 | TP4 | +1V8 | NadiSense:TestPad_D0.8mm | Bottom
1 | TP5 | GND | NadiSense:TestPad_D0.8mm | Bottom
1 | TP6 | MR | NadiSense:TestPad_D0.8mm | Bottom
1 | U1 | nRF52840-CKAA | NadiSense:Nordic_WLCSP-94_3.544x3.607mm_P0.35mm | Top
1 | U2 | MAX86141ENP+ | NadiSense:Maxim_WLP-20_2.048x1.848mm_Layout5x4_P0.4mm | Top
1 | U3 | TMP117AIDRVR | Package_SON:WSON-6-1EP_2x2mm_P0.65mm_EP1x1.6mm | Top
1 | U4 | LIS2DW12TR | Package_LGA:LGA-12_2x2mm_P0.5mm | Top
1 | U5 | BQ25120AYFPR | NadiSense:TI_DSBGA-25_2.5x2.5mm_Layout5x5_P0.5mm | Top
1 | Y1 | 32MHz 8pF | Crystal:Crystal_SMD_2016-4Pin_2.0x1.6mm | Top
