yeswantsakthi-hub/NadiSense/cad/Charger_IC.stl

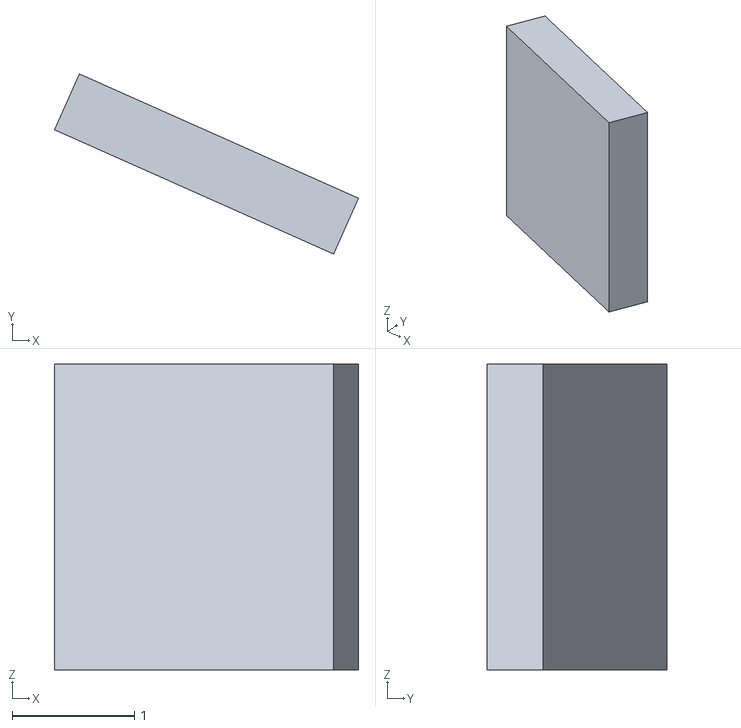
[picture p36: CAD file, 2026-10-21]
cad/Charger_IC.stl
2.49 x 1.47 x 2.50
