yeswantsakthi-hub/NadiSense/cad/PPG_module.stl

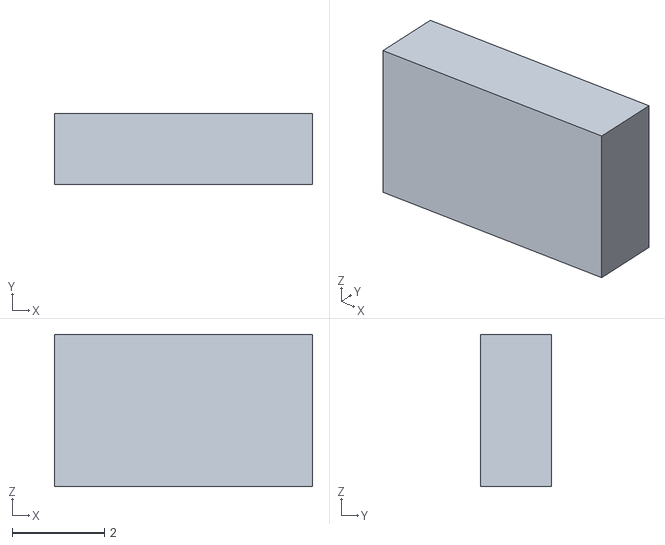
[picture p37: CAD file, 2026-10-21]
cad/PPG_module.stl
5.60 x 1.55 x 3.30
