yeswantsakthi-hub/NadiSense/cad/Outer_shell.step

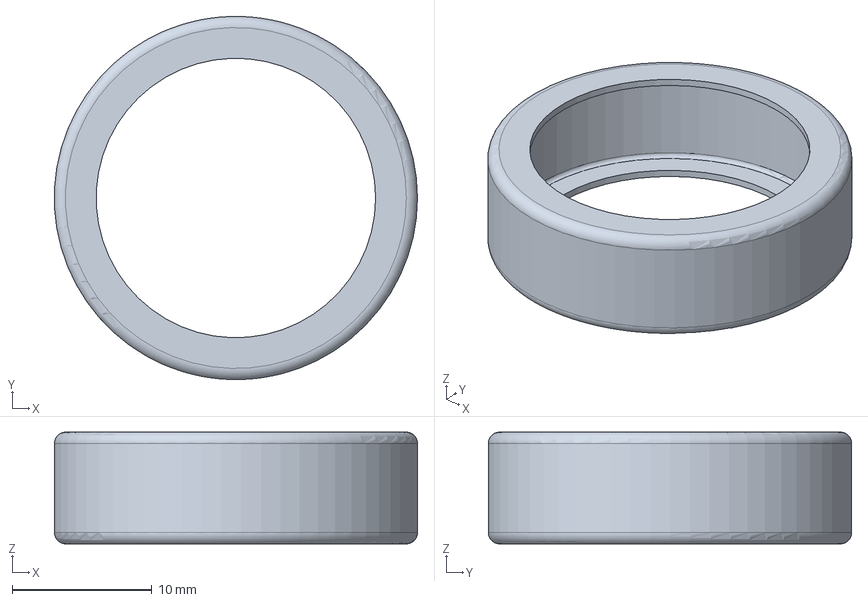
[picture p38: CAD file, 2026-10-21]
cad/Outer_shell.step
26.0 x 26.0 x 8.00 mm
