yeswantsakthi-hub/NadiSense/cad/NadiSense_Ring_v2.step

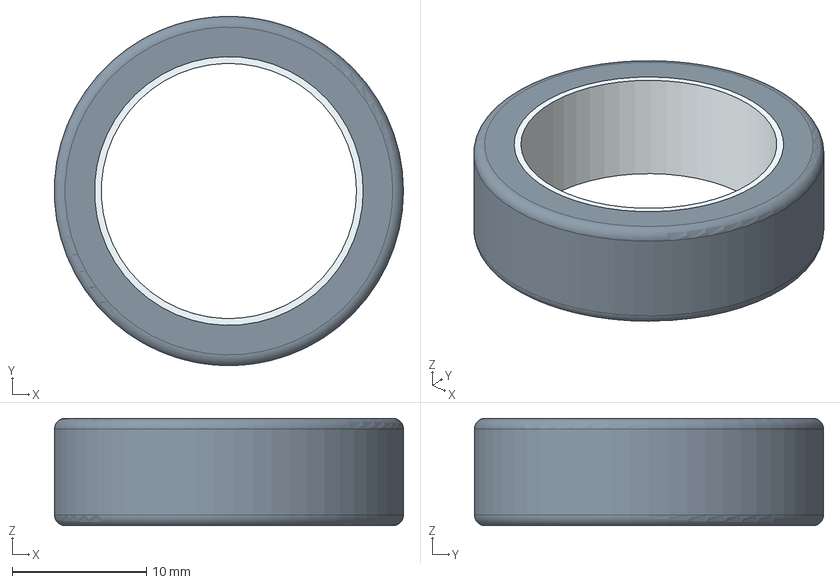
[picture p39: CAD file, 2026-10-21]
cad/NadiSense_Ring_v2.step
26.0 x 26.0 x 8.00 mm
Outer_shell
Inner_liner
Optical_window
Flex_PCB
Li-Po_cell
PPG_module
Temp_sensor
BLE_SoC
Accelerometer
Charger_IC
Crystal
Chip_antenna
Charge_contacts
