yeswantsakthi-hub/NadiSense/cad/BLE_SoC.stl

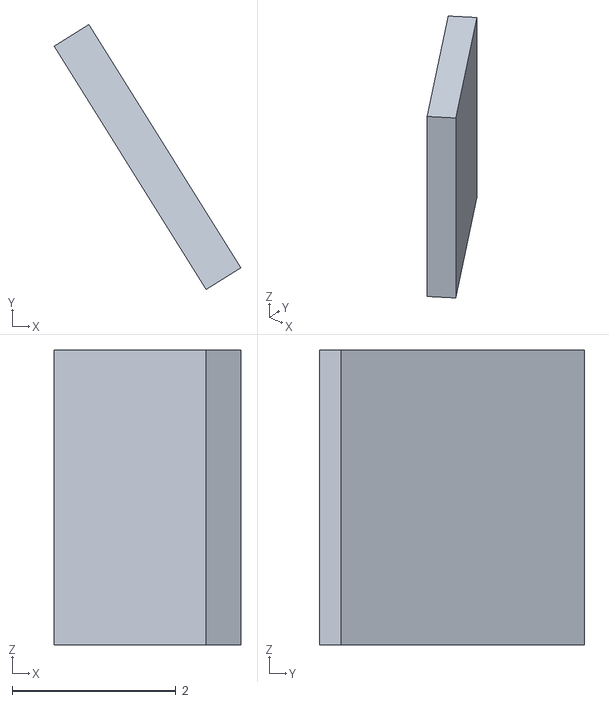
[picture p40: CAD file, 2026-10-21]
cad/BLE_SoC.stl
2.28 x 3.23 x 3.60
