yeswantsakthi-hub/NadiSense/cad/Accelerometer.stl

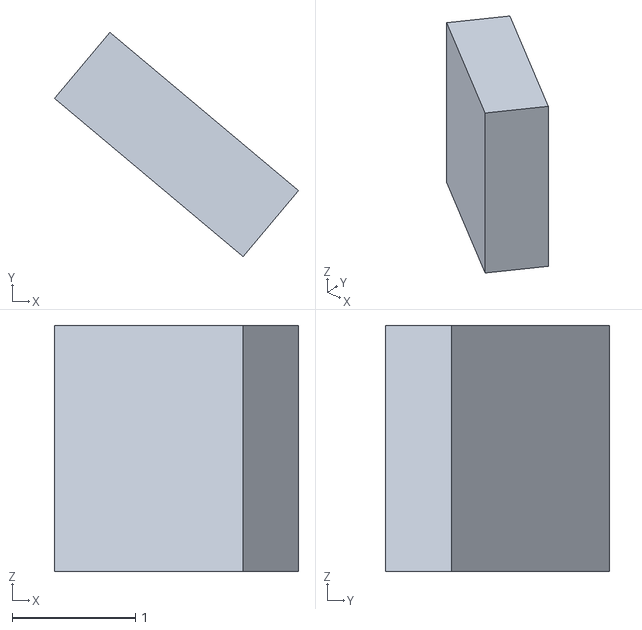
[picture p41: CAD file, 2026-10-21]
cad/Accelerometer.stl
1.98 x 1.82 x 2.00
