yeswantsakthi-hub/NadiSense/cad/Optical_window.stl

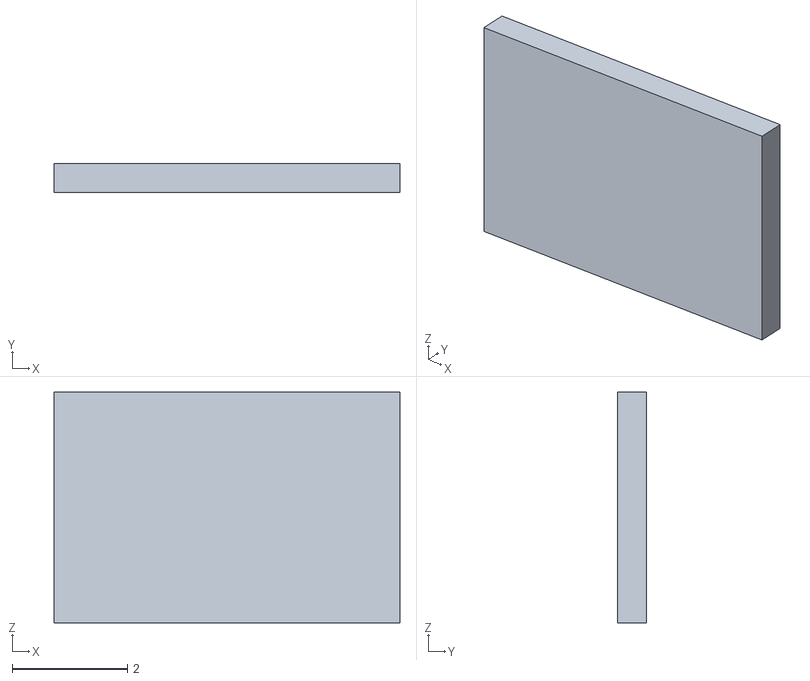
[picture p42: CAD file, 2026-10-21]
cad/Optical_window.stl
6.00 x 0.5 x 4.00
