yeswantsakthi-hub/NadiSense/cad/Charge_contacts.stl

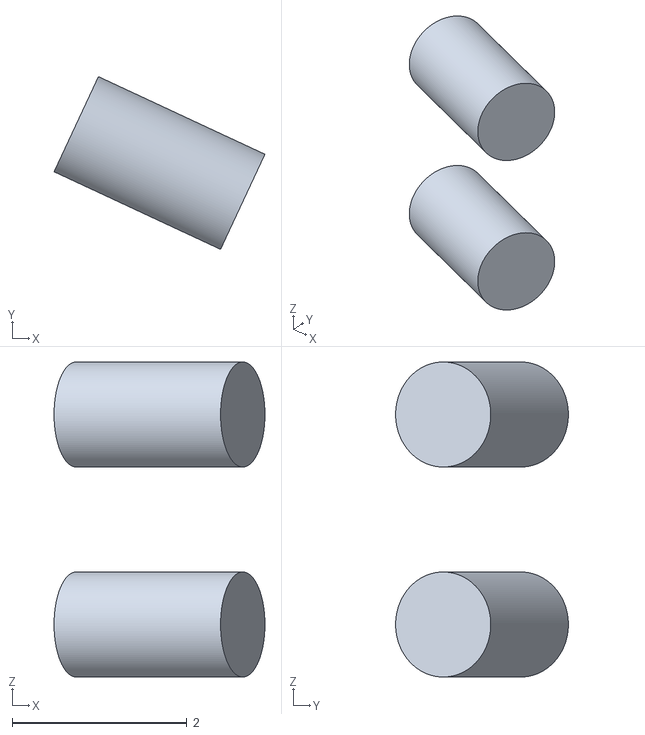
[picture p43: CAD file, 2026-10-21]
cad/Charge_contacts.stl
2.41 x 1.97 x 3.60
