yeswantsakthi-hub/NadiSense/cad/Flex_PCB.stl

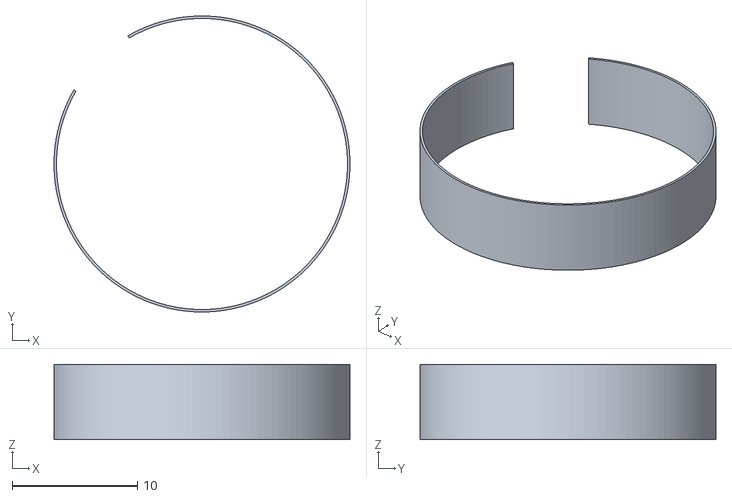
[picture p44: CAD file, 2026-10-21]
cad/Flex_PCB.stl
23.6 x 23.6 x 6.00
