yeswantsakthi-hub/NadiSense/cad/Crystal.stl

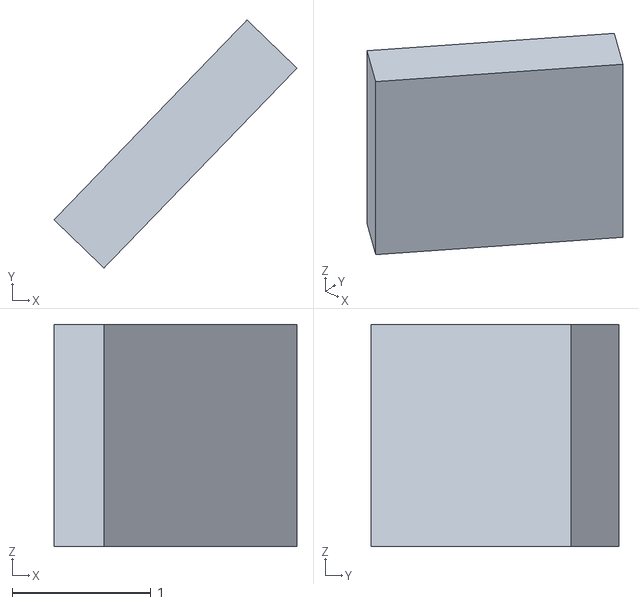
[picture p45: CAD file, 2026-10-21]
cad/Crystal.stl
1.75 x 1.79 x 1.60
