yeswantsakthi-hub/NadiSense/cad/Temp_sensor.stl

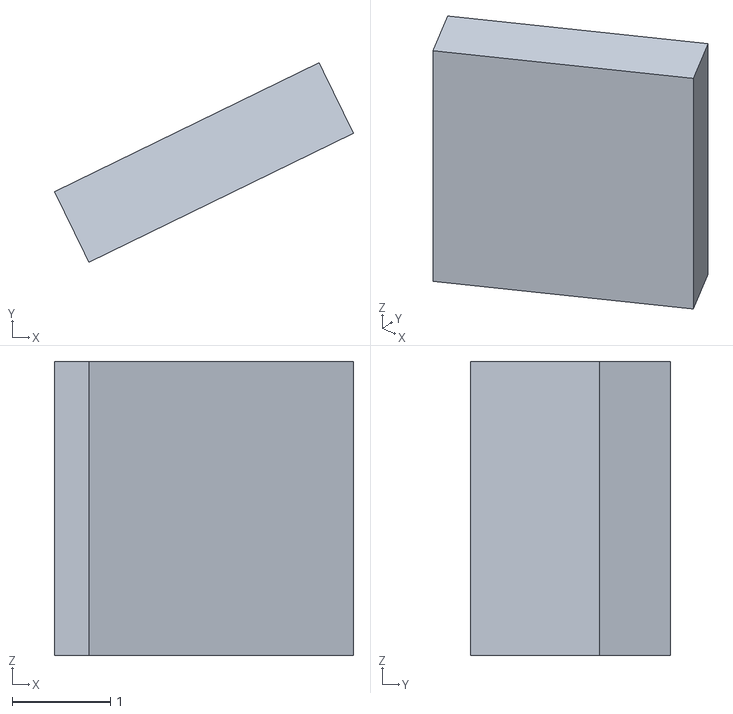
[picture p46: CAD file, 2026-10-21]
cad/Temp_sensor.stl
3.05 x 2.03 x 3.00
