yeswantsakthi-hub/NadiSense/cad/Chip_antenna.stl

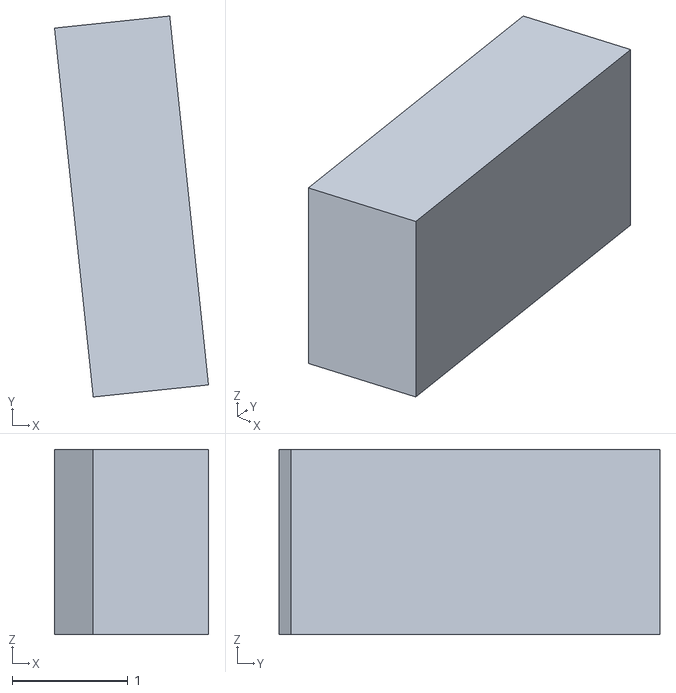
[picture p47: CAD file, 2026-10-21]
cad/Chip_antenna.stl
1.33 x 3.29 x 1.60
