yeswantsakthi-hub/NadiSense/cad/Li-Po_cell.stl

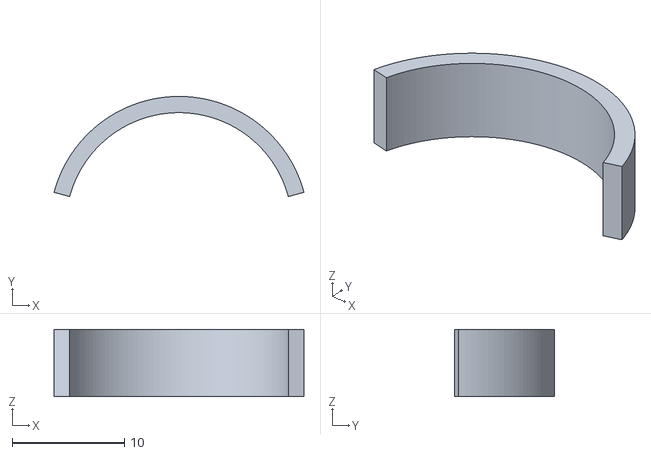
[picture p48: CAD file, 2026-10-21]
cad/Li-Po_cell.stl
22.3 x 8.93 x 6.00
