yeswantsakthi-hub/NadiSense/cad/Inner_liner.stl

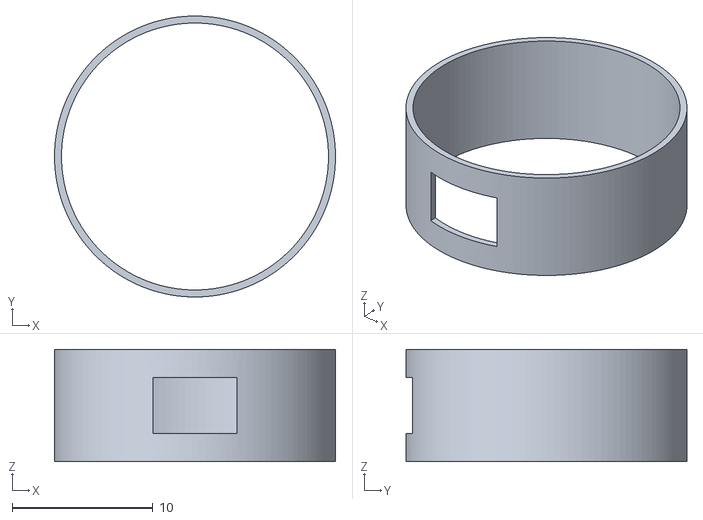
[picture p49: CAD file, 2026-10-21]
cad/Inner_liner.stl
20.0 x 20.0 x 8.00
