yeswantsakthi-hub/NadiSense/(list of files, cad)

Other CAD files:
cad/Outer_shell.stl
