yeswantsakthi-hub/NadiSense/electronics/ring_v2_revB/images/pcb_assembly_top.png

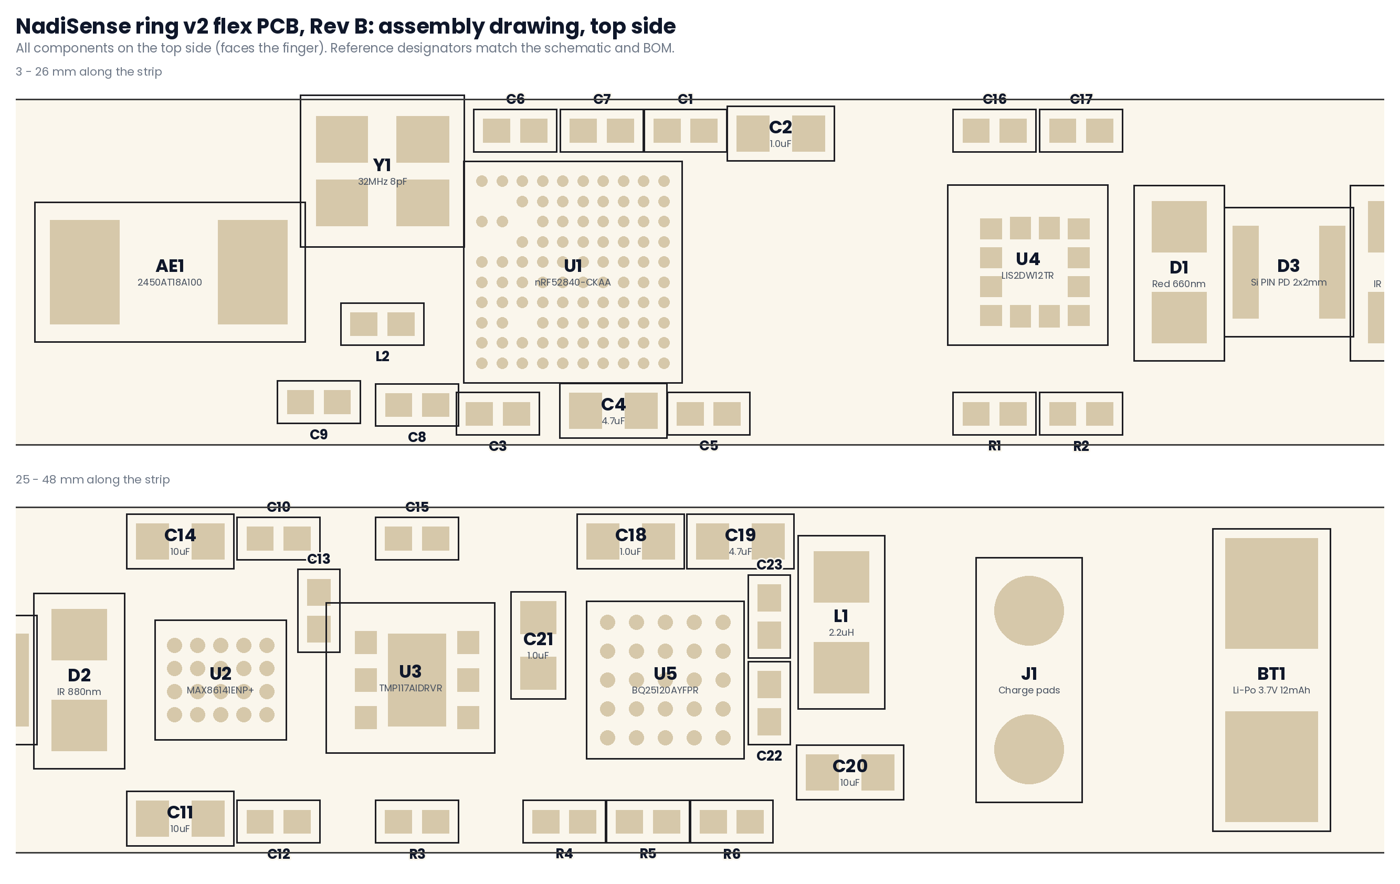
electronics/ring_v2_revB/images/pcb_assembly_top.png
