yeswantsakthi-hub/NadiSense/renders/iso_assembled_crop.png

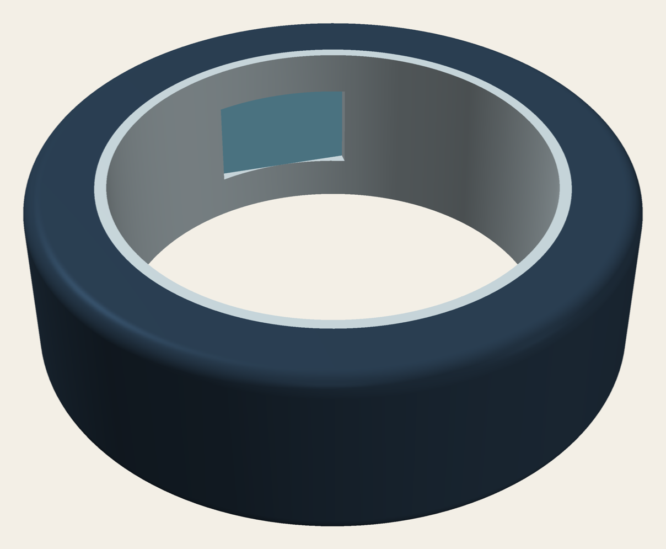
renders/iso_assembled_crop.png
