yeswantsakthi-hub/NadiSense/electronics/ring_v2_revB/NadiSense_ring_v2_revB_bottom.pdf

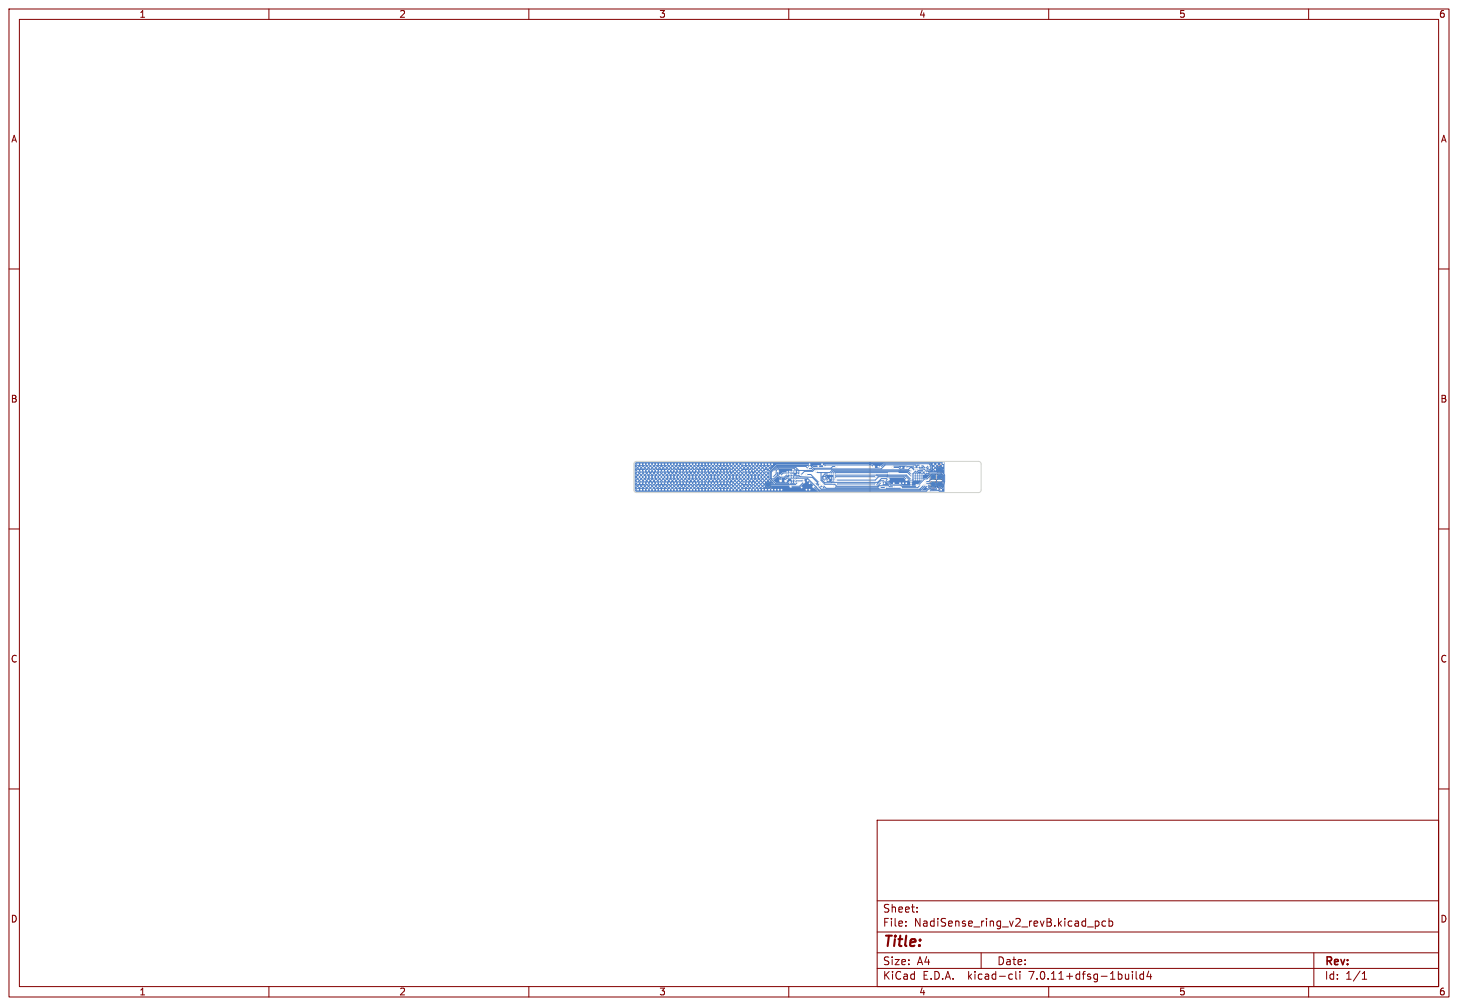
[picture p54: page 1]

Id: 1/1 Title: File: NadiSense_ring_v2_revB.kicad_pcb Sheet:
