yeswantsakthi-hub/NadiSense/electronics/ring_v2_revB/NadiSense_ring_v2_revB_schematic.pdf

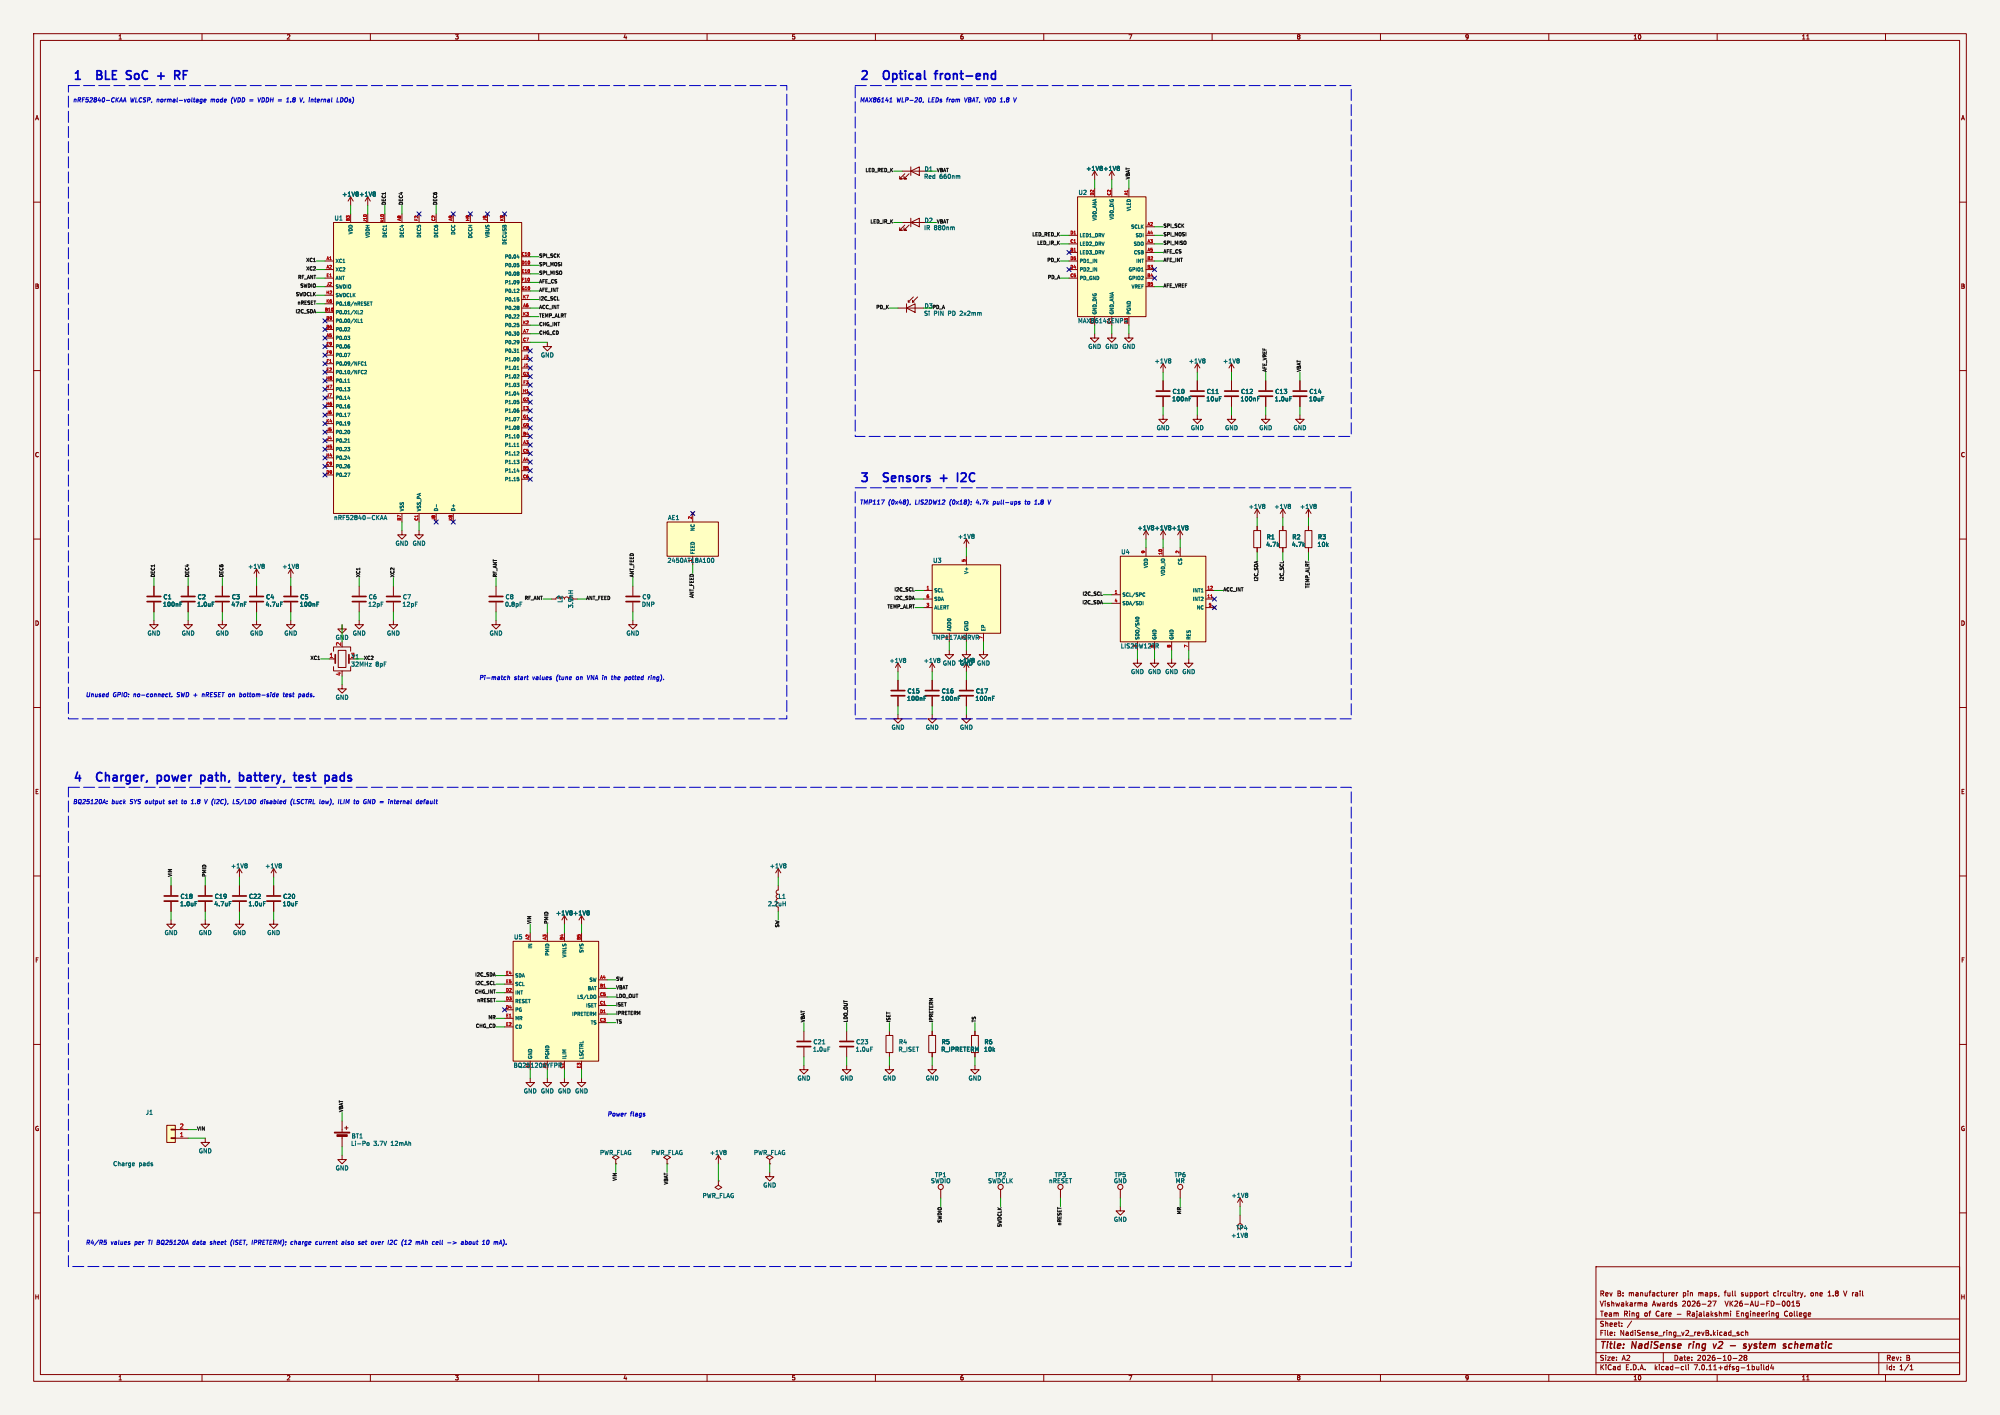
[picture p55: page 1]

+1V8 VLED A1 SCLK A2 SDO A3 SDI A4 CSB A5 LED3_DRV B1

4 Charger, power path, battery, test pads
