yeswantsakthi-hub/NadiSense/electronics/kicad/NadiSense_ring_v2.pdf

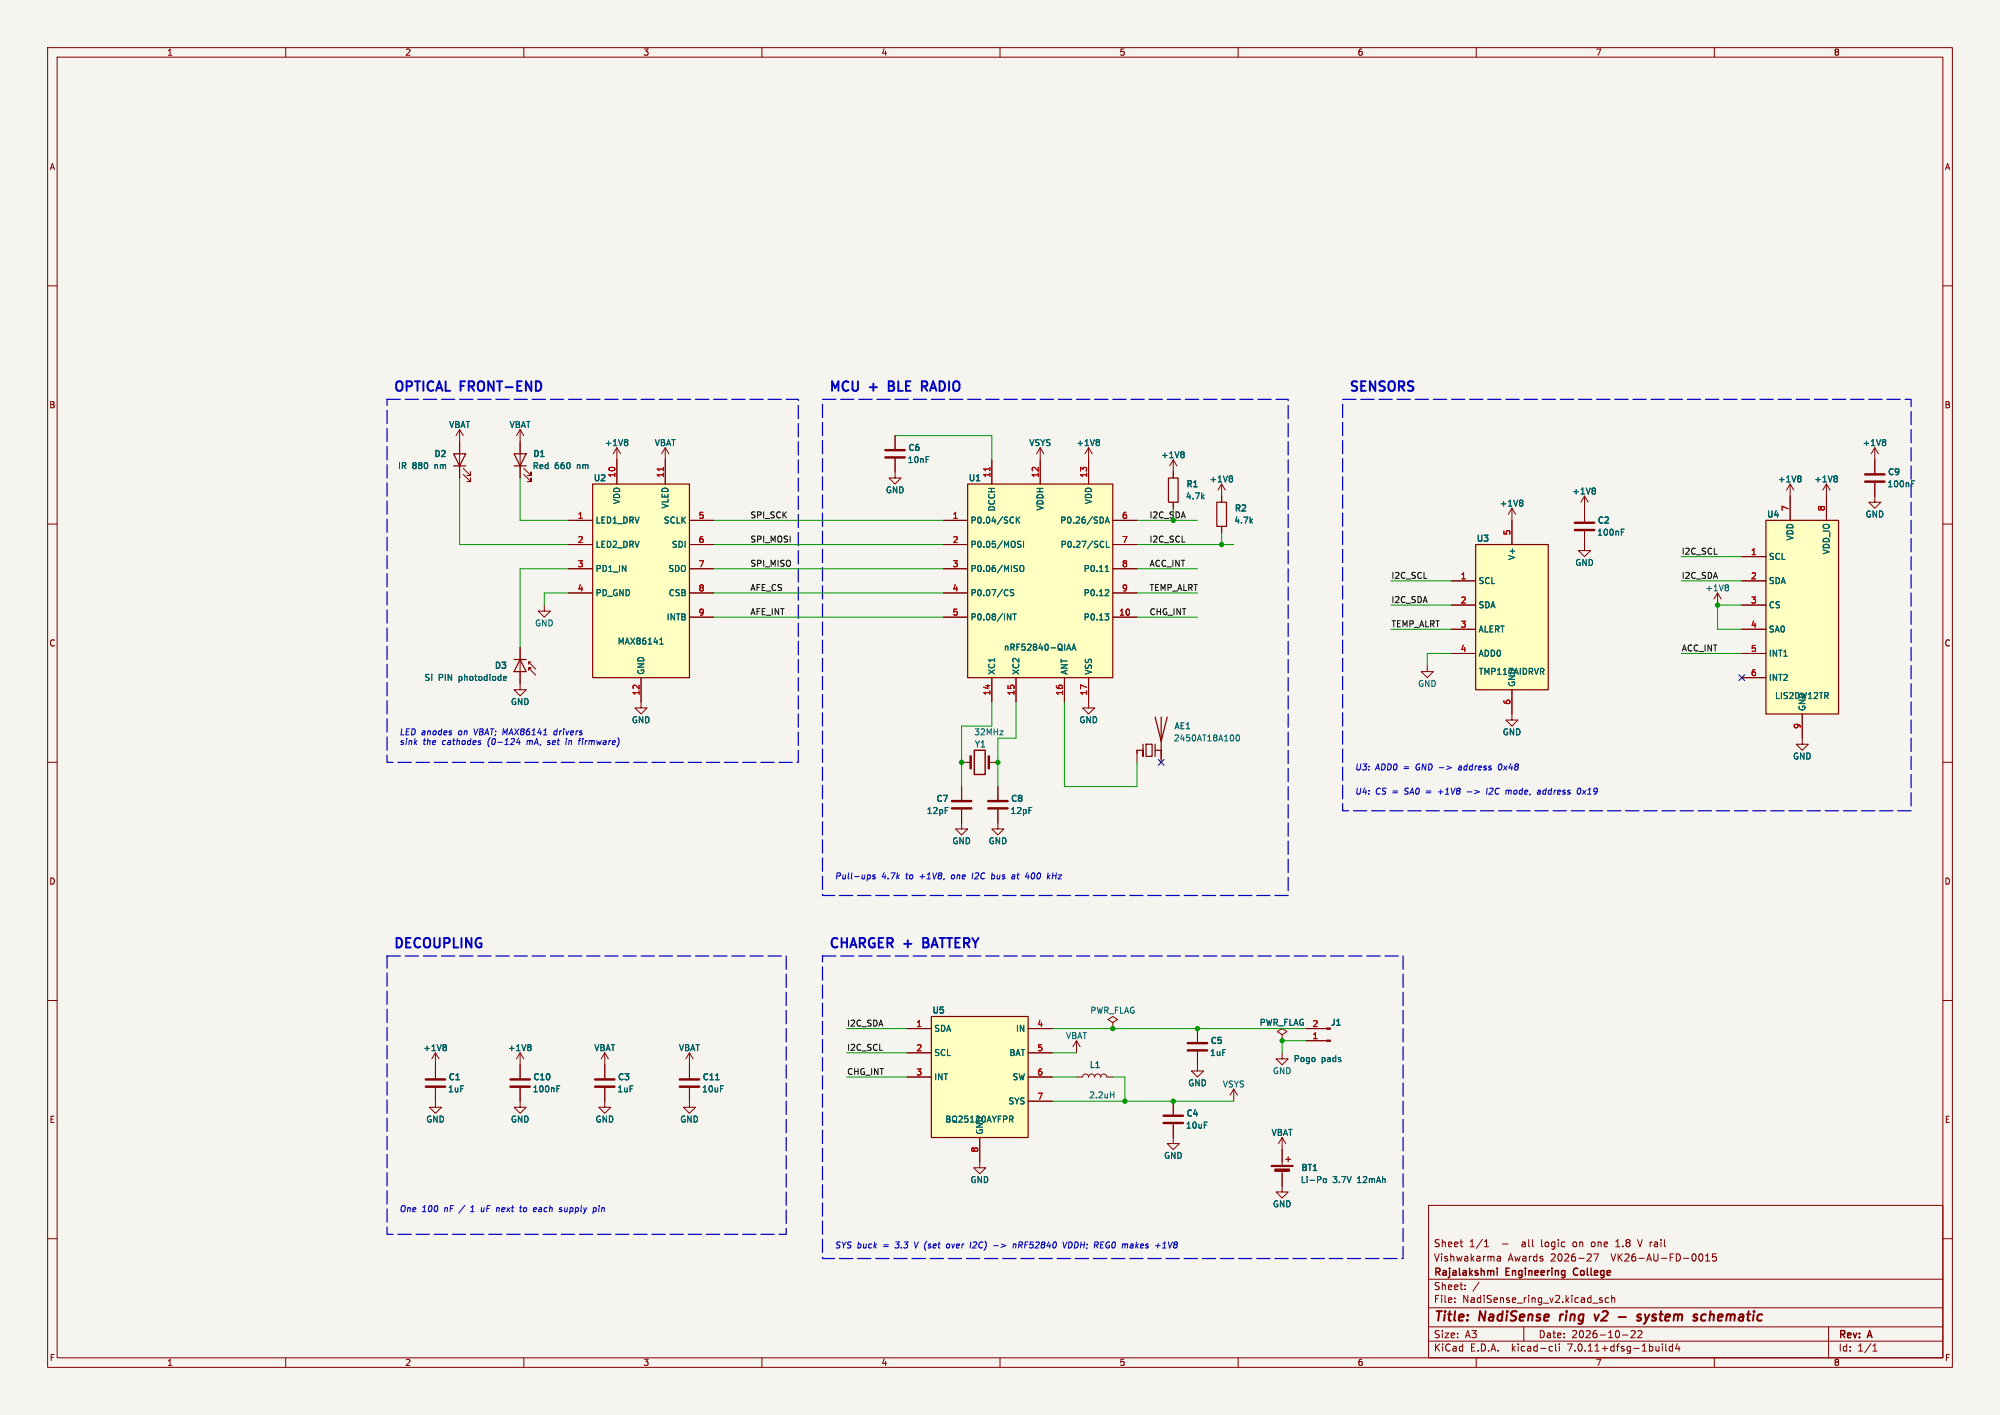
[picture p56: page 1]

Id: 1/1 Title: NadiSense ring v2 - system schematic
