yeswantsakthi-hub/NadiSense/electronics/ring_v2_revB/NadiSense_ring_v2_revB_top.pdf

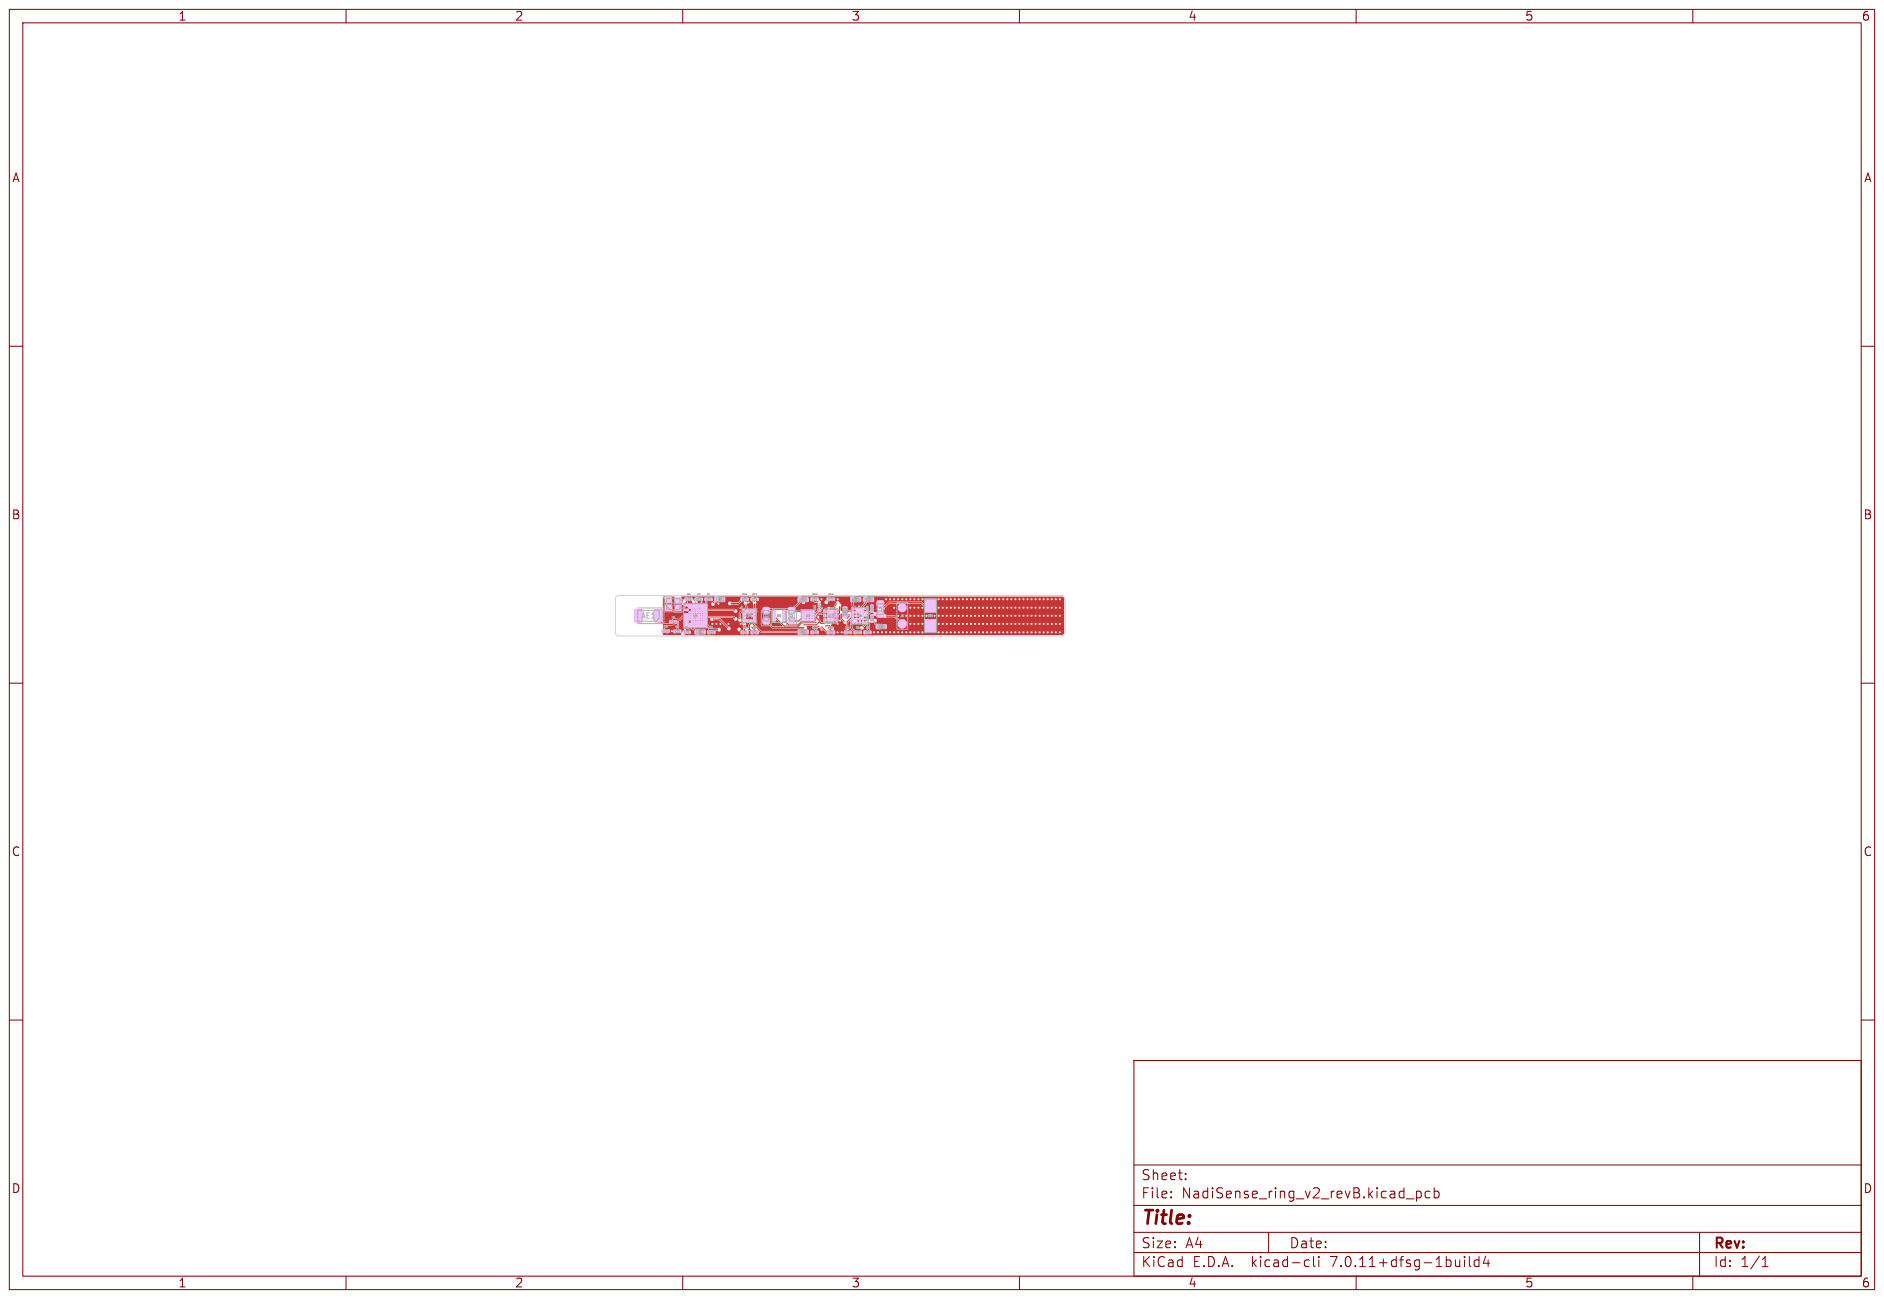
[picture p57: page 1]
