yeswantsakthi-hub/NadiSense/(list of files, drawings)

Other design files:
electronics/ring_v2_revB/NadiSense_ring_v2_revB.dsn
