yeswantsakthi-hub/NadiSense/electronics/ring_v2_revB/NadiSense_ring_v2_revB.kicad_pcb

## KiCad design electronics/ring_v2_revB/NadiSense_ring_v2_revB.kicad_pcb (2026-10-28)

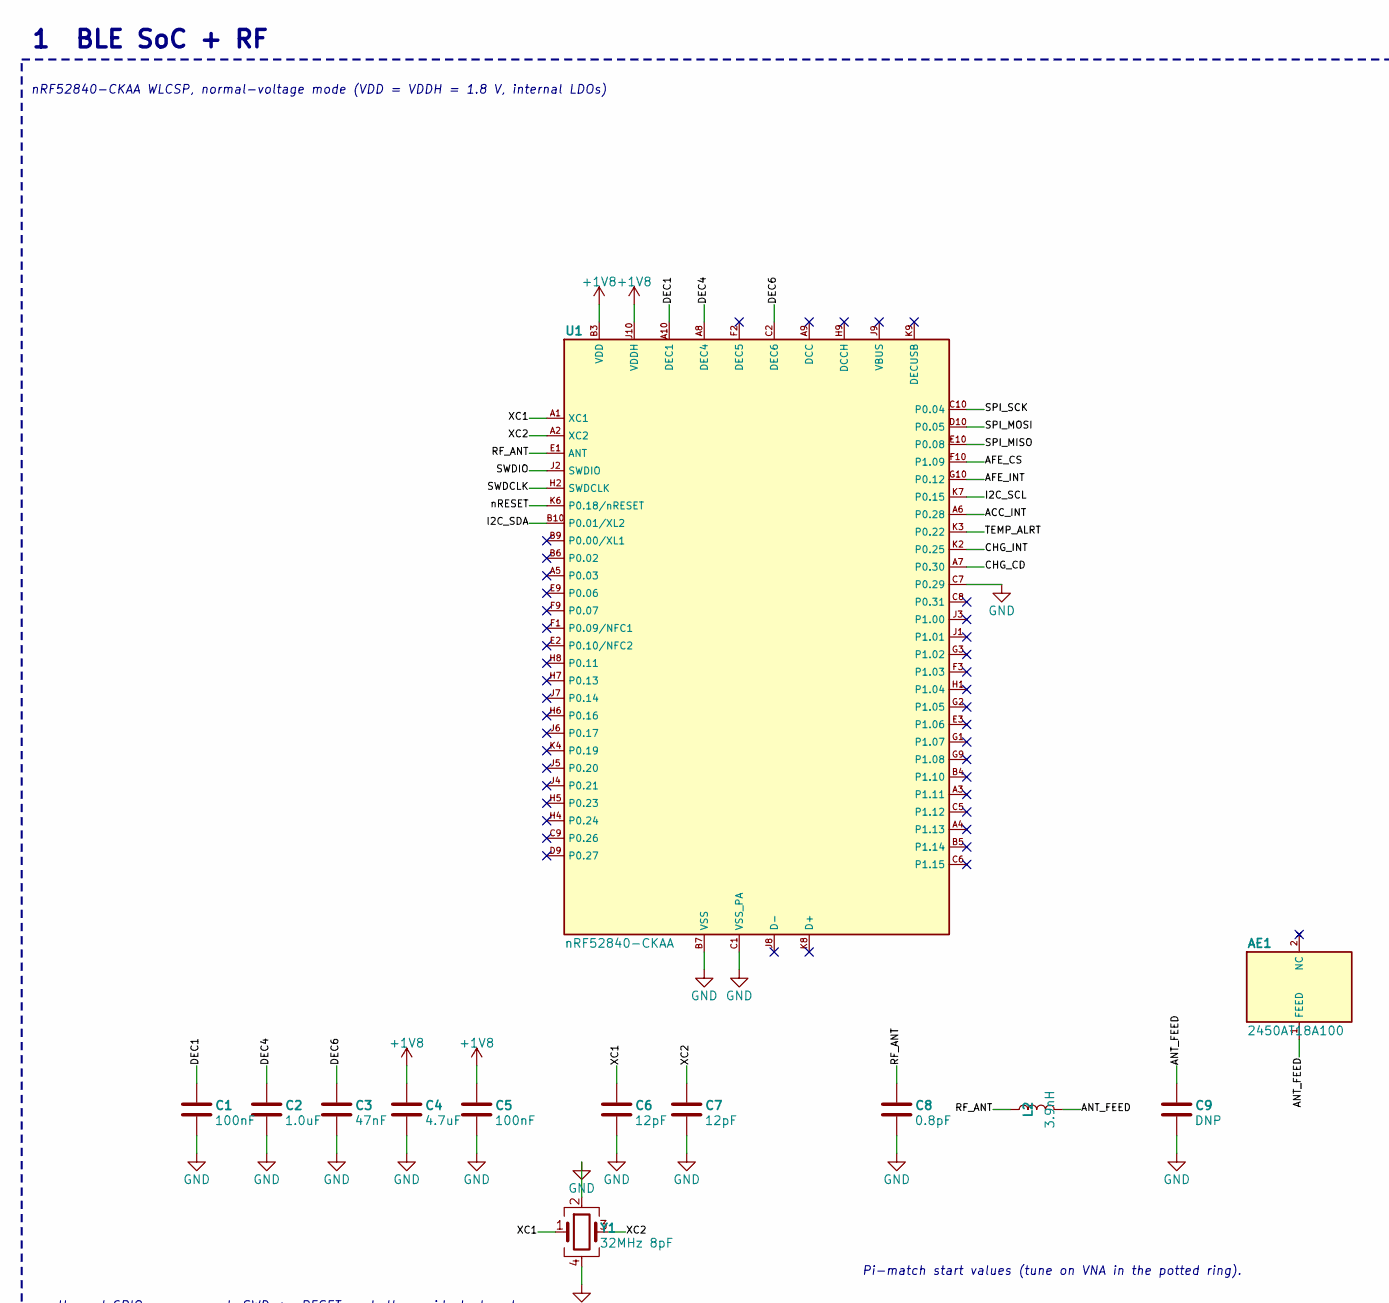
[picture p58: schematic NadiSense_ring_v2_revB.kicad_sch, NadiSense ring v2 - system schematic, part in row 1, column 1]

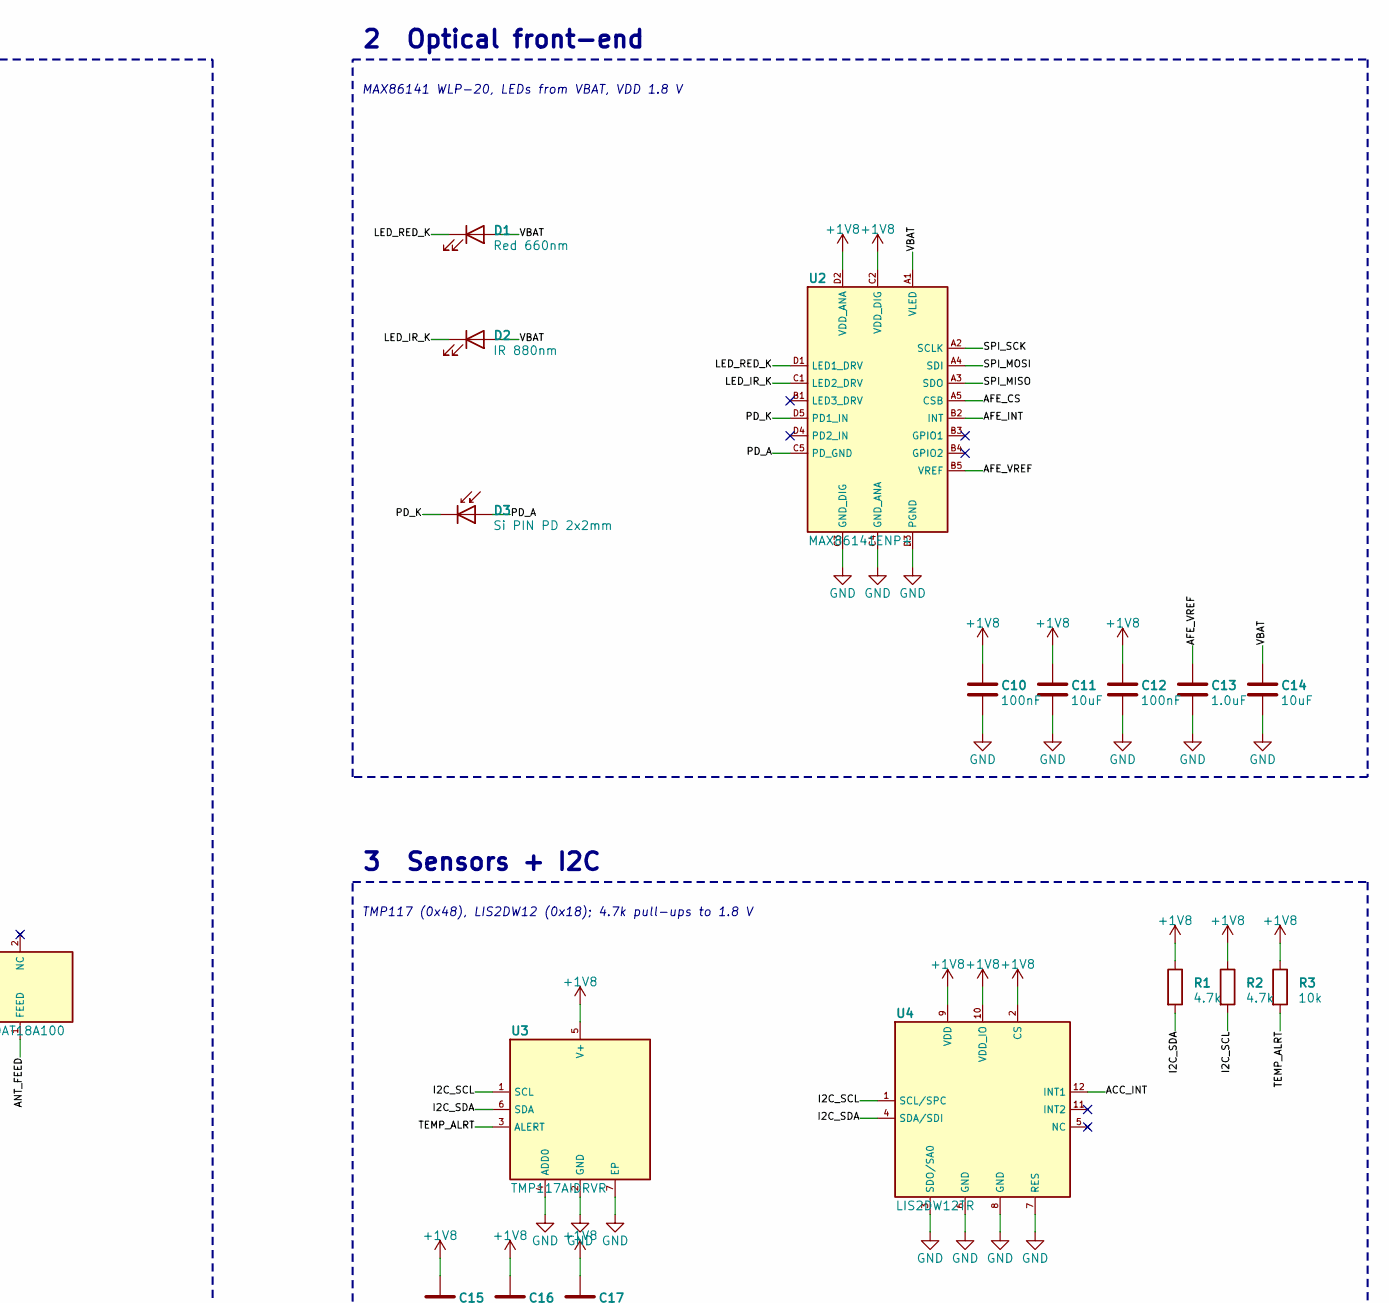
[picture p59: schematic NadiSense_ring_v2_revB.kicad_sch, NadiSense ring v2 - system schematic, part in row 1, column 2]

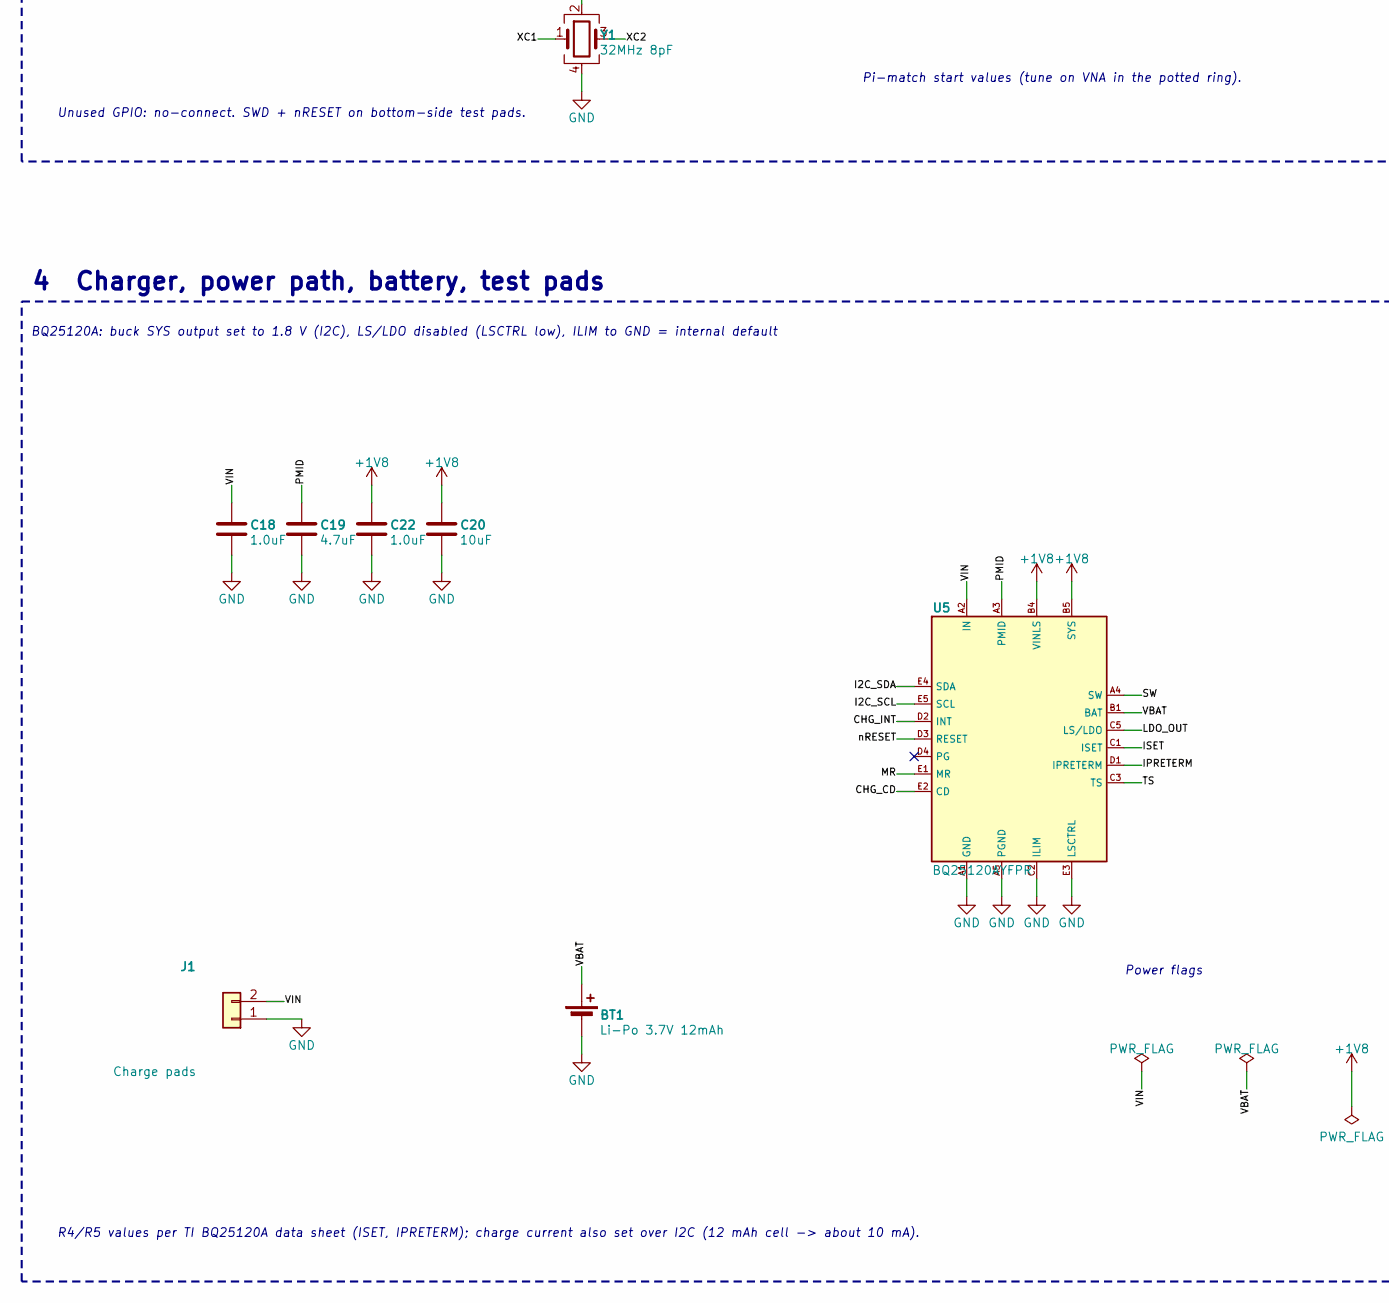
[picture p60: schematic NadiSense_ring_v2_revB.kicad_sch, NadiSense ring v2 - system schematic, part in row 2, column 1]

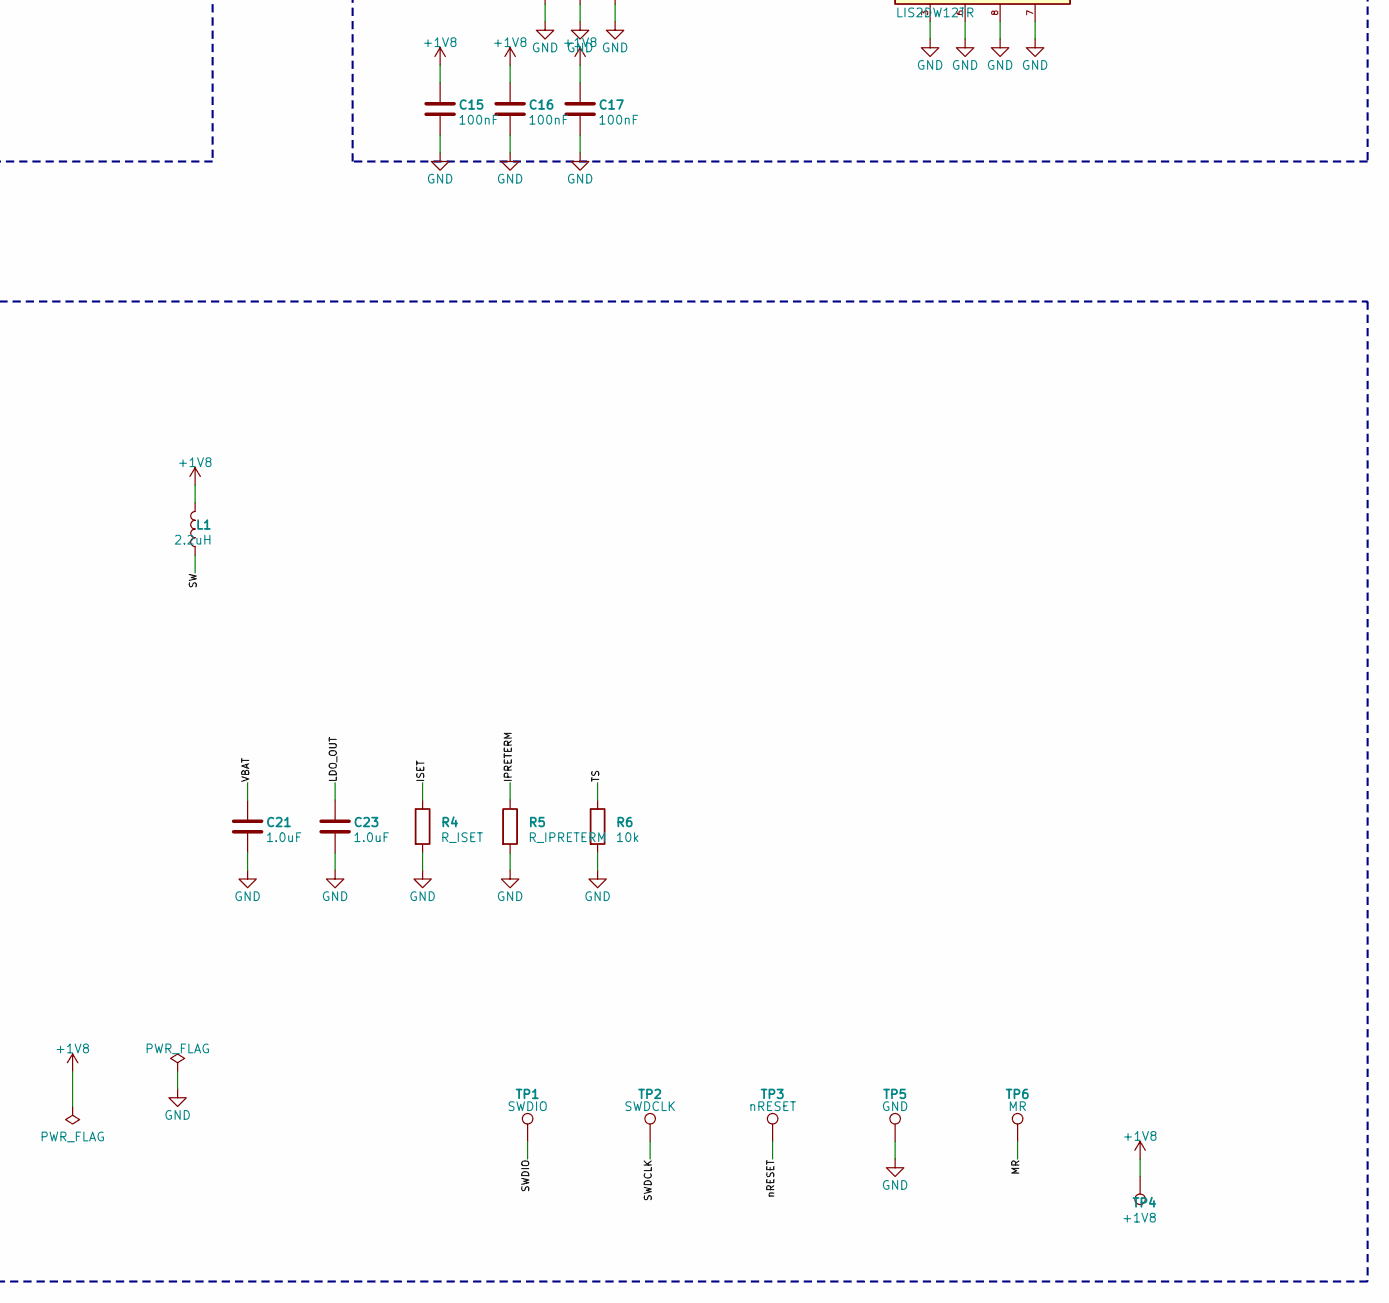
[picture p61: schematic NadiSense_ring_v2_revB.kicad_sch, NadiSense ring v2 - system schematic, part in row 2, column 2]

Parts:
AE1: 2450AT18A100; Johanson_2450AT18x100
BT1: Li-Po 3.7V 12mAh; LiPo_Tabs_1.6x1.9mm
C1, C5, C10, C12, C15, C16, C17: 100nF; C_0201_0603Metric
C2, C18, C21: 1.0uF; C_0402_1005Metric
C3: 47nF; C_0201_0603Metric
C4, C19: 4.7uF; C_0402_1005Metric
C6, C7: 12pF; C_0201_0603Metric
C8: 0.8pF; C_0201_0603Metric
C9: DNP; C_0201_0603Metric
C11, C14, C20: 10uF; C_0402_1005Metric
C13, C22, C23: 1.0uF; C_0201_0603Metric
D1: Red 660nm; LED_0603_1608Metric
D2: IR 880nm; LED_0603_1608Metric
D3: Si PIN PD 2x2mm; PD_2x2mm
J1: Charge pads; ChargePads_2xD1.2mm
L1: 2.2uH; L_0603_1608Metric
L2: 3.9nH; L_0201_0603Metric
R1, R2: 4.7k; R_0201_0603Metric
R3, R6: 10k; R_0201_0603Metric
R4: R_ISET; R_0201_0603Metric
R5: R_IPRETERM; R_0201_0603Metric
TP1: SWDIO; TestPad_D0.8mm
TP2: SWDCLK; TestPad_D0.8mm
TP3: nRESET; TestPad_D0.8mm
TP4: +1V8; TestPad_D0.8mm
TP5: GND; TestPad_D0.8mm
TP6: MR; TestPad_D0.8mm
U1: nRF52840-CKAA; Nordic_WLCSP-94_3.544x3.607mm_P0.35mm
U2: MAX86141ENP+; Maxim_WLP-20_2.048x1.848mm_Layout5x4_P0.4mm
U3: TMP117AIDRVR; WSON-6-1EP_2x2mm_P0.65mm_EP1x1.6mm
U4: LIS2DW12TR; LGA-12_2x2mm_P0.5mm
U5: BQ25120AYFPR; TI_DSBGA-25_2.5x2.5mm_Layout5x5_P0.5mm
Y1: 32MHz 8pF; Crystal_SMD_2016-4Pin_2.0x1.6mm

Connections:
+1V8: C4.1, C5.1, C10.1, C11.1, C12.1, C15.1, C16.1, C17.1, C20.1, C22.1, L1.2, R1.1, R2.1, R3.1, TP4.1, U1.B3 (VDD), U1.B8 (VDD), U1.H10 (VDD), U1.J10 (VDDH), U1.K1 (VDD), U1.K5 (VDD), U2.C2 (VDD_DIG), U2.D2 (VDD_ANA), U3.5 (V+), U4.2 (CS), U4.9 (VDD), U4.10 (VDD_IO), U5.B4 (VINLS), U5.B5 (SYS), U5.C4 (VINLS)
/ACC_INT: U1.A6 (P0.28), U4.12 (INT1)
/AFE_CS: U1.F10 (P1.09), U2.A5 (CSB)
/AFE_INT: U1.G10 (P0.12), U2.B2 (INT)
/AFE_VREF: C13.1, U2.B5 (VREF)
/ANT_FEED: AE1.1 (FEED), C9.1, L2.2
/CHG_CD: U1.A7 (P0.30), U5.E2 (CD)
/CHG_INT: U1.K2 (P0.25), U5.D2 (INT)
/DEC1: C1.1, U1.A10 (DEC1)
/DEC4: C2.1, U1.A8 (DEC4)
/DEC6: C3.1, U1.C2 (DEC6)
/I2C_SCL: R2.2, U1.K7 (P0.15), U3.1 (SCL), U4.1 (SCL/SPC), U5.E5 (SCL)
/I2C_SDA: R1.2, U1.B10 (P0.01/XL2), U3.6 (SDA), U4.4 (SDA/SDI), U5.E4 (SDA)
/IPRETERM: R5.1, U5.D1 (IPRETERM)
/ISET: R4.1, U5.C1 (ISET)
/LDO_OUT: C23.1, U5.C5 (LS/LDO)
/LED_IR_K: D2.1 (K), U2.C1 (LED2_DRV)
/LED_RED_K: D1.1 (K), U2.D1 (LED1_DRV)
/MR: TP6.1, U5.E1 (MR)
/PD_A: D3.2 (A), U2.C5 (PD_GND)
/PD_K: D3.1 (K), U2.D5 (PD1_IN)
/PMID: C19.1, U5.A3 (PMID), U5.B3 (PMID)
/RF_ANT: C8.1, L2.1, U1.E1 (ANT)
/SPI_MISO: U1.E10 (P0.08), U2.A3 (SDO)
/SPI_MOSI: U1.D10 (P0.05), U2.A4 (SDI)
/SPI_SCK: U1.C10 (P0.04), U2.A2 (SCLK)
/SW: L1.1, U5.A4 (SW)
/SWDCLK: TP2.1, U1.H2 (SWDCLK)
/SWDIO: TP1.1, U1.J2 (SWDIO)
/TEMP_ALRT: R3.2, U1.K3 (P0.22), U3.3 (ALERT)
/TS: R6.1, U5.C3 (TS)
/VBAT: BT1.1 (+), C14.1, C21.1, D1.2 (A), D2.2 (A), U2.A1 (VLED), U5.B1 (BAT), U5.B2 (BAT)
/VIN: C18.1, J1.2, U5.A2 (IN)
/XC1: C6.1, U1.A1 (XC1), Y1.1
/XC2: C7.1, U1.A2 (XC2), Y1.3
/nRESET: TP3.1, U1.K6 (P0.18/nRESET), U5.D3 (RESET)
GND: BT1.2 (-), C1.2, C2.2, C3.2, C4.2, C5.2, C6.2, C7.2, C8.2, C9.2, C10.2, C11.2, C12.2, C13.2, C14.2, C15.2, C16.2, C17.2, C18.2, C19.2, C20.2, C21.2, C22.2, C23.2, J1.1, R4.2, R5.2, R6.2, TP5.1, U1.B7 (VSS), U1.C1 (VSS_PA), U1.C4 (VSS), U1.C7 (P0.29), U1.D3 (VSS), U1.D4 (VSS), U1.D5 (VSS), U1.D6 (VSS), U1.D7 (VSS), U1.D8 (VSS), U1.E4 (VSS), U1.E5 (VSS), U1.E6 (VSS), U1.E7 (VSS), U1.E8 (VSS), U1.F4 (VSS), U1.F5 (VSS), U1.F6 (VSS), U1.F7 (VSS), U1.F8 (VSS), U1.G4 (VSS), U1.G5 (VSS), U1.G6 (VSS), U1.G7 (VSS), U1.G8 (VSS), U1.K10 (VSS), U2.C3 (GND_DIG), U2.C4 (GND_ANA), U2.D3 (PGND), U3.2 (GND), U3.4 (ADD0), U3.7 (EP), U4.3 (SDO/SA0), U4.6 (GND), U4.7 (RES), U4.8 (GND), U5.A1 (GND), U5.A5 (PGND), U5.C2 (ILIM), U5.D5 (GND), U5.E3 (LSCTRL), Y1.2, Y1.4

Notes on the sheet:
1 BLE SoC + RF
nRF52840-CKAA WLCSP, normal-voltage mode (VDD = VDDH = 1.8 V, internal LDOs)
Pi-match start values (tune on VNA in the potted ring).
Unused GPIO: no-connect. SWD + nRESET on bottom-side test pads.
2 Optical front-end
MAX86141 WLP-20, LEDs from VBAT, VDD 1.8 V
3 Sensors + I2C
TMP117 (0x48), LIS2DW12 (0x18); 4.7k pull-ups to 1.8 V
4 Charger, power path, battery, test pads
BQ25120A: buck SYS output set to 1.8 V (I2C), LS/LDO disabled (LSCTRL low), ILIM to GND = internal default
R4/R5 values per TI BQ25120A data sheet (ISET, IPRETERM); charge current also set over I2C (12 mAh cell -> about 10 mA).
Power flags

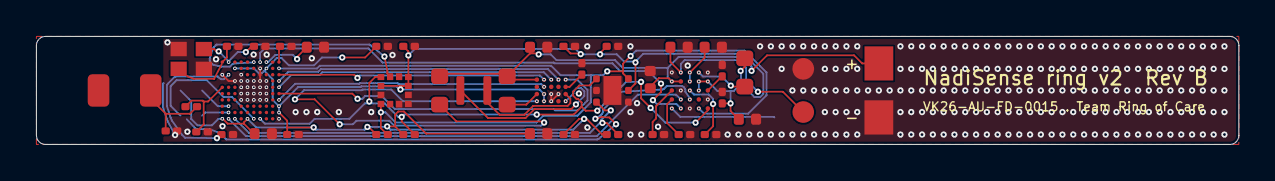
[picture p62: board NadiSense_ring_v2_revB.kicad_pcb from above]

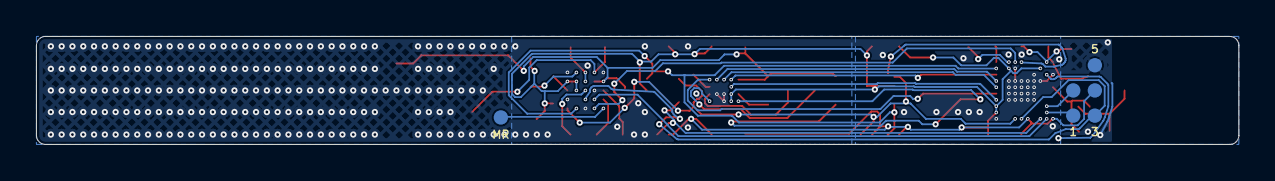
[picture p63: board NadiSense_ring_v2_revB.kicad_pcb from below]

Board: 2 copper layers, 66.8 x 6.0 mm, 49 parts (6 on the bottom side), 37 nets.
