yeswantsakthi-hub/NadiSense/(commit log)

2026-10-02 Phase 1: scaffold app with mock sensor data and live waveform
    - Vite + React 18 + TypeScript (strict) + Tailwind v4, Vitest
    - SensorSource interface; MockSource streams PPG (400 Hz), IMU (50 Hz),
    ECG sessions (250 Hz) and temperature on one shared clock
    - Deterministic MockSignalModel: two-Gaussian PPG with dicrotic notch,
    HR 60-80 bpm, respiration 14/min, motion bursts, P-QRS-T ECG with
    200-250 ms pulse arrival time; normal / irregular / apnea-night scenarios
    - BleSource placeholder so the source toggle works ahead of phase 5
    - Canvas WaveformCanvas: smooth scrolling, ECG-paper grid, dark mode,
    reduced-motion snapshot mode
    - Hash routing, Connect, Dashboard, Settings; later screens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
2026-10-04 Redesign as a dark instrument console
    - Dark console theme: ink panels, hairline borders, khaki labels,
    teal signal, amber movement flags; IBM Plex Mono for figures
    - Status banner (LIVE / MOVEMENT) with guidance and key figures,
    event log, session + streams panel, Nadi panel, vital cards
    - dsp/motion.ts: accelerometer movement score with hysteresis and
    segment flagging, tested against mock movement bursts
    - SessionMonitor feeds a live store and display buffers so data
    persists across screens
    - Waveform: motion-flagged stretches shaded and faded, scale fitted
    to clean signal, accelerometer strip under the pulse
    - Desktop two-column layout with top tabs; compact phone layout
    keeps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
2026-10-04 Add Firebase backend: profile, cloud backup, recordings, doctor links
    - Firestore data layer (src/cloud): profile with BP cuff calibration,
    per-type consent, session summaries saved every 5 min and on
    disconnect, 30 s raw PPG/IMU recordings, doctor share links
    - Security rules: owner-only access, writes gated by consent,
    share links readable by exact token until expiry, never listable
    - Screens: consent prompt after first sign-in; Settings profile,
    cloud backup and data panels (export, delete data, delete account);
    History table (7/30 days); doctor links with copy and revoke;
    public read-only share page
    - New strings in all 8 languages; Firebase split into its own chunk
    - Tests f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
2026-10-21 NadiSense ring v2: Stage 2 design files
    CAD (STEP/STL + parametric script), FEA study, power budget, KiCad 7 schematic and netlist, renders, design summary and Stage 2 deck.
    Claude-Session: https://claude.ai/code/session_01GSbfriCuRPxdbSTHDeqRus
    [Accelerometer.stl, BLE_SoC.stl, Charge_contacts.stl, Charger_IC.stl, Chip_antenna.stl, Crystal.stl, Flex_PCB.stl, Inner_liner.stl]
2026-10-21 Update Stage 2 deck PDF with repository link
    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
2026-10-22 KiCad: fix ERC (power flags, pin types, project library); add FreeCAD and KiCad screenshots
    KiCad 7 Electrical Rules Check now reports 0 errors and 0 warnings (electronics/kicad/ERC.rpt).
    Deck PDF updated with a Design Tools slide.
    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
    [NadiSense_ring_v2.kicad_sch]
2026-10-24 Deck: photo frame on Maker Journey slide
    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
2026-10-25 Flex PCB render; CAD labels match ring v2 parts
    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
2026-10-25 Flex PCB render: photo-style shading, traces, vias, markings
    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
2026-10-25 Render flex PCB wrapped into ring shape with Li-Po cell
    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
2026-10-28 Flex PCB Rev A: KiCad layout, routing, DRC-clean, Gerbers and build scripts
    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
    [NadiSense_flex-BOM.csv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]
2026-10-28 Rev B schematic and flex PCB: manufacturer pin maps, routed, DRC clean
    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
    [NadiSense_flex-BOM.csv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]
2026-11-09 Stage 3 Task 1: real ring over Bluetooth, simulator on the same packets
    - src/ring/contract.ts: v1 BLE contract (service, live, command UUIDs;
    16-byte little-endian live packet; reserved field is beat_seq)
    - packets.ts: parser/encoder and commands, unit-tested first
    - One data path: PacketSource parses bytes for every source;
    SimulatedRing encodes the same packets (normal, irregular,
    finger off, movement); BluetoothRing connects via Web Bluetooth,
    syncs time, starts streaming, reconnects with back-off
    - Reading gate: HR/SpO2 only with finger on, confidence >= 80, still
    - Header link chip (status + battery); ring is the default source
    - Dashboard shows packet data with a beat strip (r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
2026-11-09 Stage 3 Tasks 2-4: honest screens, validation mode, navy theme
    Task 2, honest data
    - Rhythm screen from real RR intervals over 2 min: RMSSD, pNN50,
    consecutive beats only (beat_seq), movement skipped; flag wording
    "Possible irregular rhythm - check with a doctor" (dsp/rhythm.ts)
    - Skin temperature as drift from the person's first 3 sessions
    (dsp/baseline.ts); ring and simulated sessions kept apart
    - Sessions stored on the phone (Dexie) with gated HR/SpO2 means and
    rhythm; History reads local data and works offline
    - ECG, BP trend, Nadi shape, sleep/apnea marked "Coming in v2", no
    numbers; raw-recording consent and BP cuff entry hidden for v1
    - Sign-in optional ("Use without account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
2026-11-09 Redesign as a wellness app (Oura/Whoop style)
    - New look: near-black with a soft teal glow, raised rounded-3xl
    surfaces, pill buttons, thin oversized numbers, one colour per metric
    - Home: hero ring gauge with live heart rate (gated), confidence arc and
    a heart that pops on every real beat; beat strip; plain-language
    insight; SpO2 / temperature drift / rhythm mini gauges; rhythm card
    with disclaimer; session details folded away
    - Pairing: ring artwork, three guided checks, one Connect button,
    error cards with concrete fixes, demo behind "Try the demo"
    - Validation: 4-step flow, countdown ring with live readings, volunteer
    code auto-advances, within/outside tolerance per measure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
2026-11-10 Demo tour scenario for the Stage 3 video
    New simulator scenario walks through every state in one run: steady reading
    (25 s), movement (10 s, HOLD STILL), ring off (10 s, PLACE RING), then
    irregular beats; the rhythm flag appears once its full 2-minute window is
    in (~2 min). A strip on the Pulse screen labels the demo and the current step.
    Tested end to end through the reading gate and rhythm screen.
2026-11-11 Ring diagnostics screen for firmware bring-up
    Settings > Ring diagnostics shows, over the last minute: packets/s, beats/min,
    longest gap, missed beats (beat_seq), bad packets, finger-on %, confidence
    (with a trace against the 80 gate), motion %, battery and drain rate (after
    5 min), ring clock drift, and six BLE-contract checks from FIRMWARE.md, plus
    the last packet as hex and decoded fields. Analysis is pure and tested; a
    rolling 10-minute packet log feeds it.
2026-11-11 History trends: heart rate, temperature drift and rhythm per session
    History now charts each session in the chosen range (Recharts, loaded on
    demand): mean heart rate, skin-temperature drift from the personal baseline
    (once 3 sessions set it), and rhythm RMSSD with flagged sessions marked red.
    Day ticks label each date once; axes round to tidy steps. Replaces the daily
    bars. Trend data is a pure, tested function (dsp/trends.ts).
2026-11-11 Premium instrument redesign: brand, heart-rate dial, refined surfaces
    New design system: ink background with layered graphite surfaces, saffron
    brand (primary actions, active tab, selection), green only for live, red only
    for flags; IBM Plex Sans/Mono; NadiSense logo mark and wordmark.
    Pulse screen: hero with status pill, heart-rate dial lit to the reading,
    filled live waveform, and the reading gate as check pills; SpO2, temperature
    drift and rhythm cards with 10-minute sparklines; rhythm analysis as bars
    against the flag limits; event log as a timeline. Sticky blurred header,
    floating phone tab bar, page titles, new onboarding hero, restyled fields,
    buttons and segmented controls. Fixed a f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
2026-11-11 Make the app plainer and easier to read
    Sentence-case labels and card titles instead of monospaced capitals; quieter
    tags; a standard bottom tab bar that no longer floats over content.
    Ring diagnostics is now Ring health: one plain answer at the top, an
    "at a glance" list in everyday words with check marks, data checks in plain
    language, and the engineering numbers folded under Technical details.
    Event log entries show just the message and time. Status words in English
    are sentence case. Unused strings removed.
2026-11-11 Pulse fits the first phone screen, plain rhythm verdict, cleaner History
    - Pulse on phones: smaller dial and waveform, checks collapse to one line when all pass, SpO2 and temperature side by side
    - Rhythm card shows Regular / Possible irregular in words, numbers underneath
    - Paused title says 'Signal settling' when there is no movement (8 languages)
    - History: no duplicate title, separate chart and table cards, empty state
2026-11-12 Brand colour: red on black instead of orange
    Red brand token with white button text, blacker page and surfaces, red glow,
    logo, favicon and PWA icons regenerated. CLAUDE.md design notes updated.
2026-11-12 Flatter, plainer surfaces: no glows, gradients or icon tiles
    Flat cards with hairline edges, smaller corner radii, solid red button,
    numbered pairing steps and a plain pairing header instead of a hero card.
